Mehdi-Ldj/lora-ble-sensor-node/docs/renders/board-3d-bottom.png

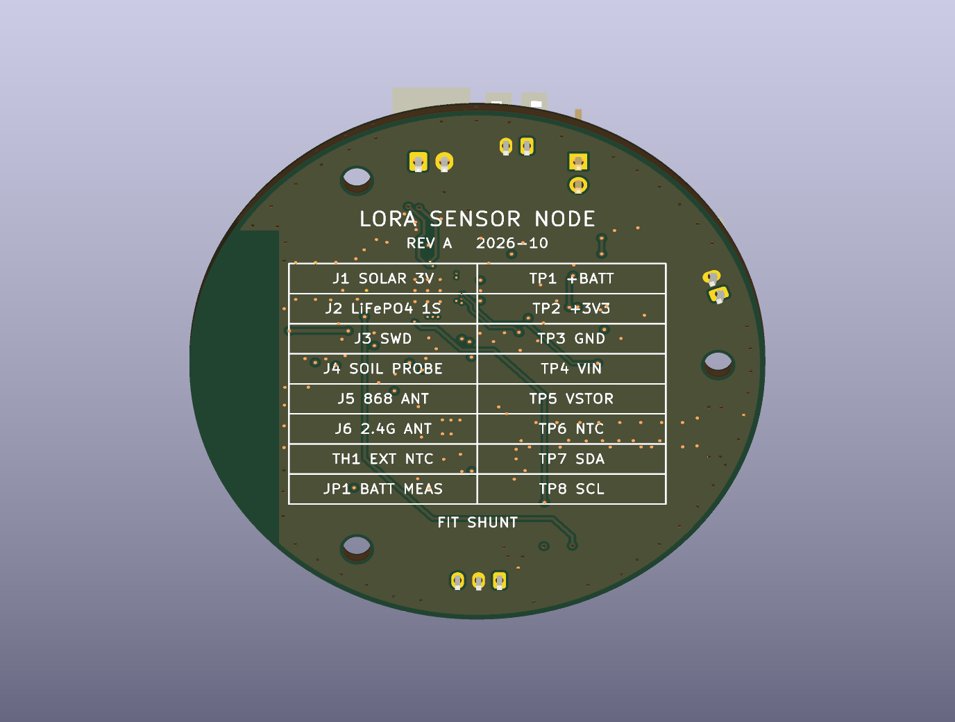
docs/renders/board-3d-bottom.png
