Mehdi-Ldj/lora-ble-sensor-node/hardware/rev-a/3dmodels/SMD1812P050TF-30.step

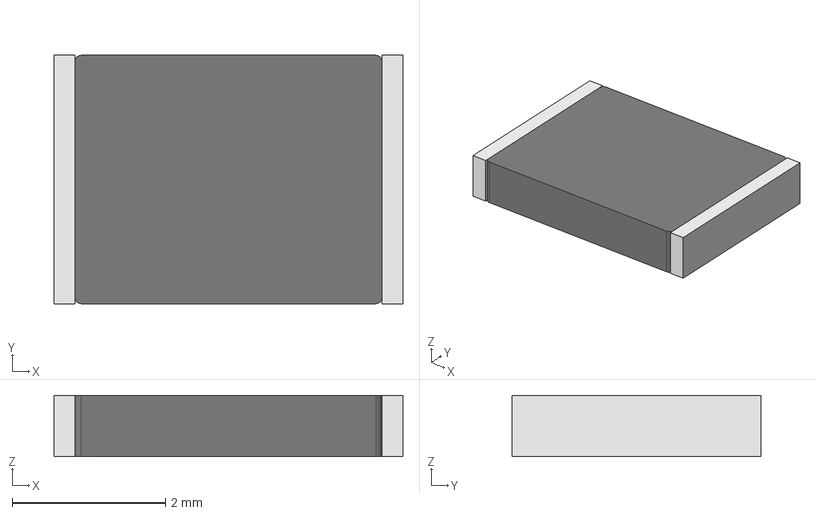
[picture p8: CAD file, 2026-10-28]
hardware/rev-a/3dmodels/SMD1812P050TF-30.step
4.55 x 3.24 x 0.8 mm
cap_-1
cap_1
