Mehdi-Ldj/lora-ble-sensor-node/hardware/rev-a/3dmodels/MM8130-2600.step

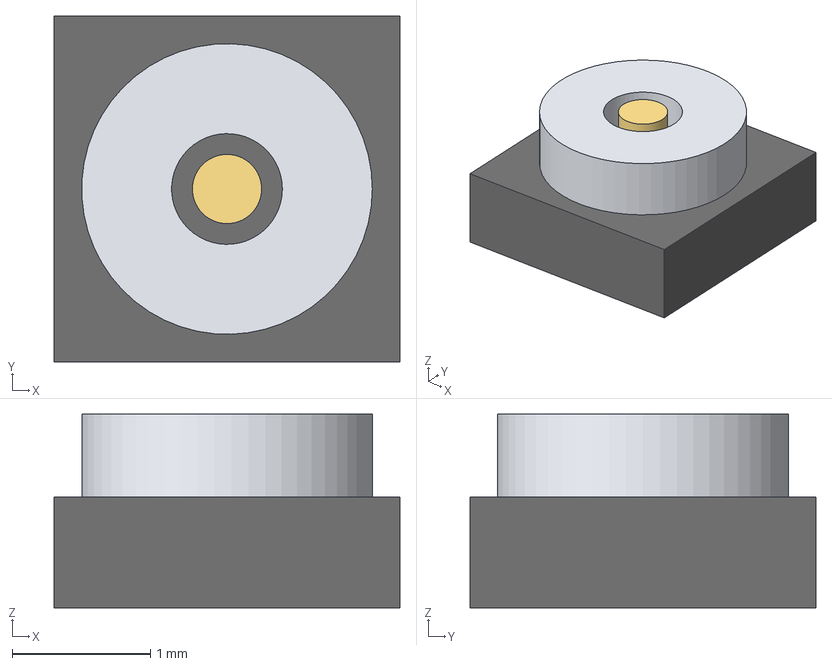
[picture p9: CAD file, 2026-10-28]
hardware/rev-a/3dmodels/MM8130-2600.step
2.50 x 2.50 x 1.40 mm
base
shield
pin
