Mehdi-Ldj/lora-ble-sensor-node/docs/renders/schematic-rev-a.pdf

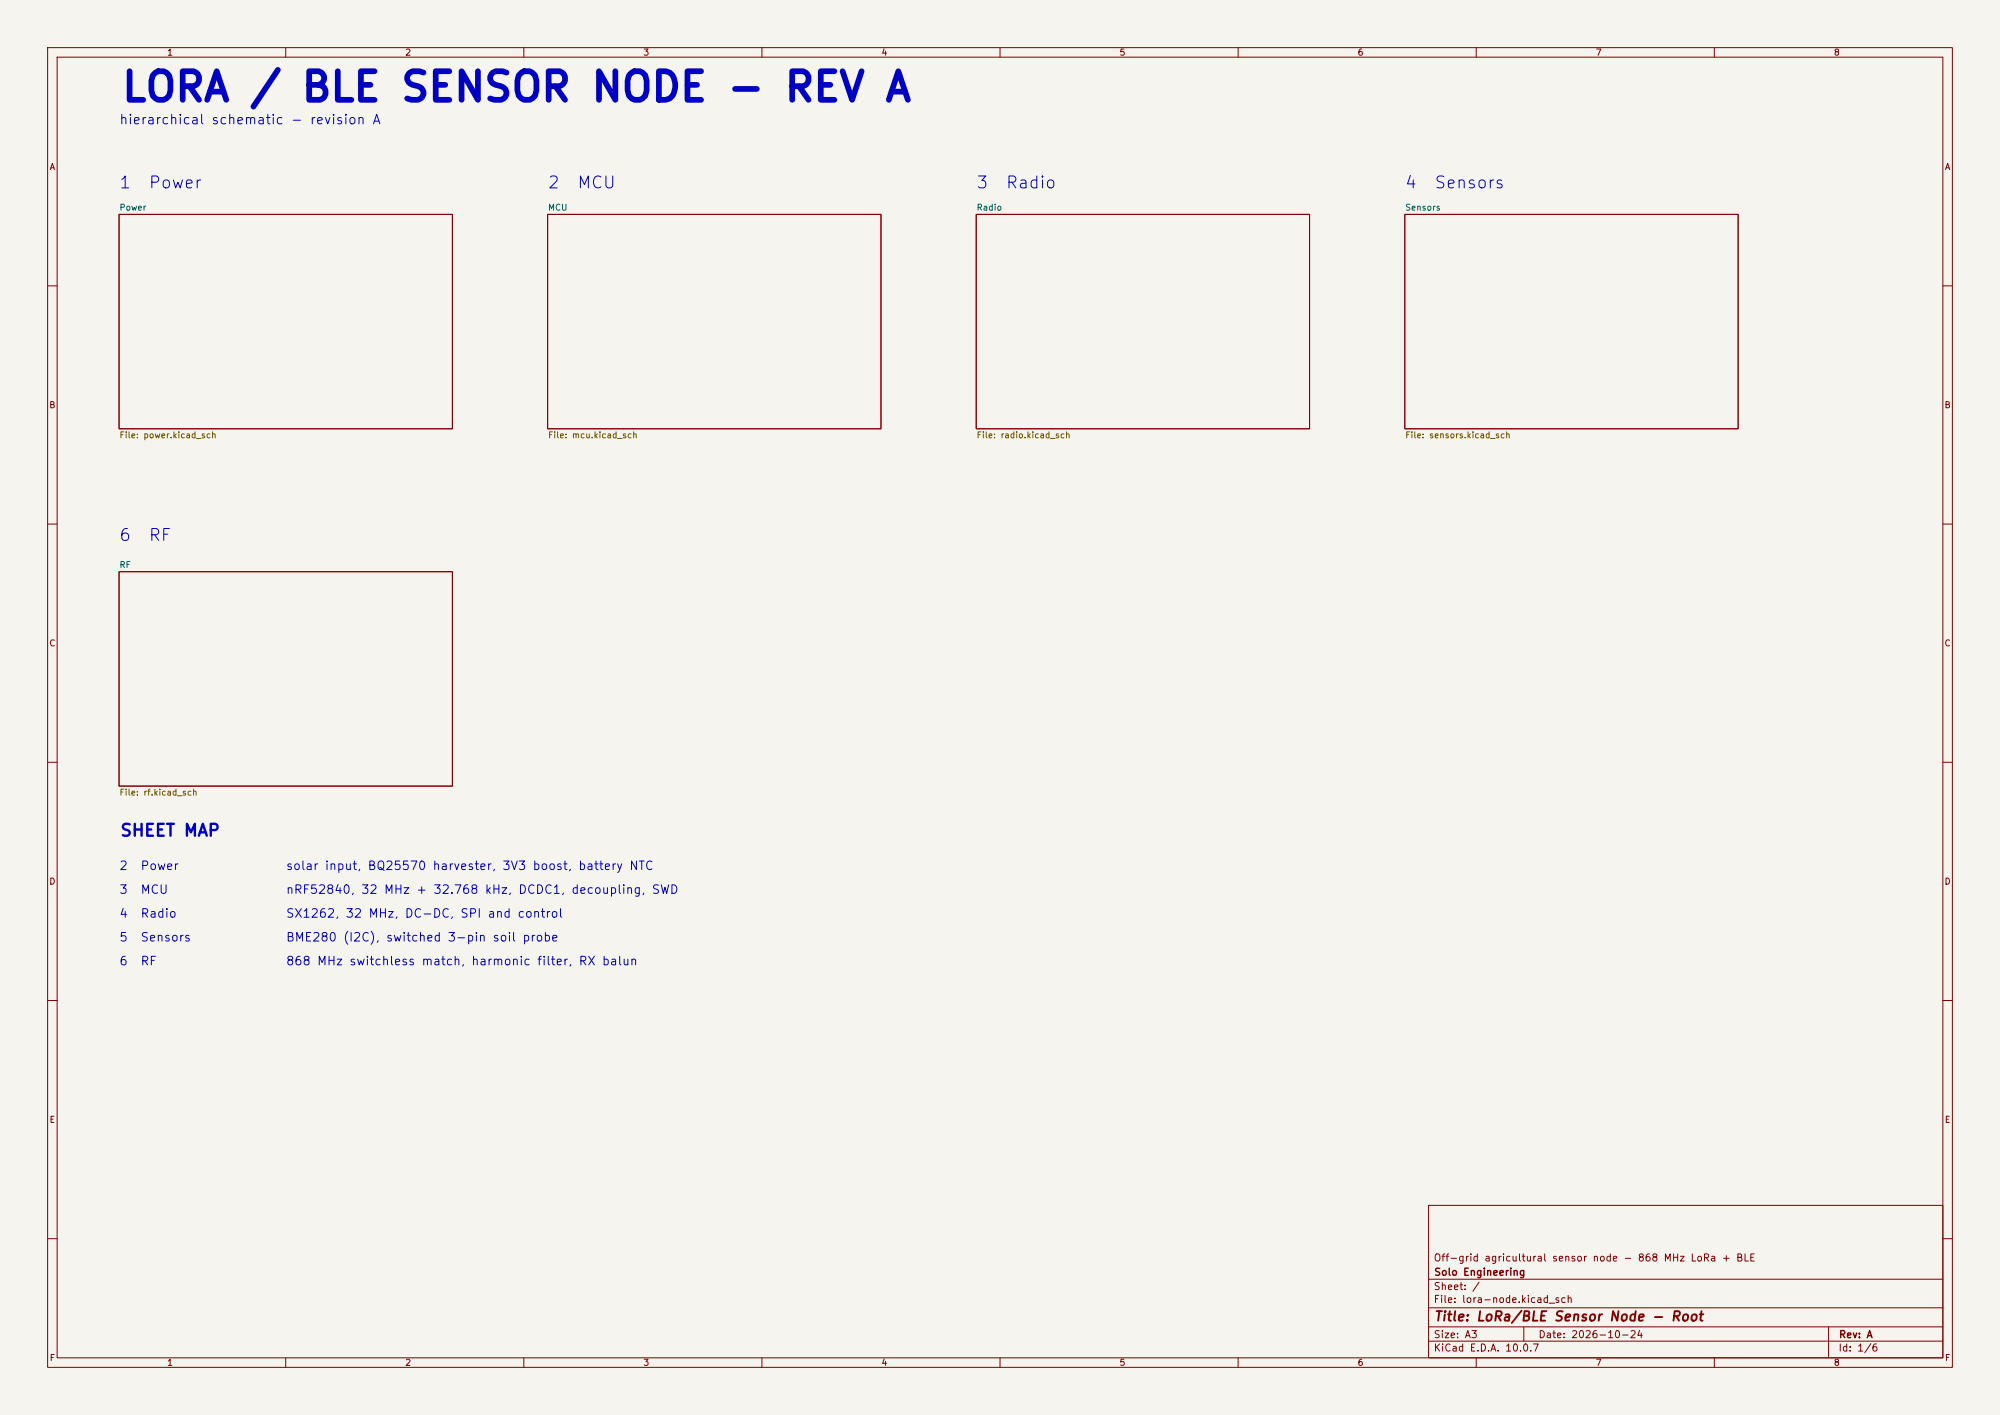
[picture p10: page 1]

LORA / BLE SENSOR NODE - REV A

File: mcu.kicad_sch Power File: power.kicad_sch RF

Sensors File: sensors.kicad_sch Radio

solar input, BQ25570 harvester, 3V3 boost, battery NTC
nRF52840, 32 MHz + 32.768 kHz, DCDC1, decoupling, SWD

SX1262, 32 MHz, DC-DC, SPI and control
BME280 (I2C), switched 3-pin soil probe

868 MHz switchless match, harmonic filter, RX balun

Off-grid agricultural sensor node - 868 MHz LoRa + BLE
Solo Engineering
Sheet: /
File: lora-node.kicad_sch
Title: LoRa/BLE Sensor Node - Root

Size: A3 | Rev: A | F Date: 2026-10-24
KiCad E.D.A. 10.0.7 | Id: 1/6

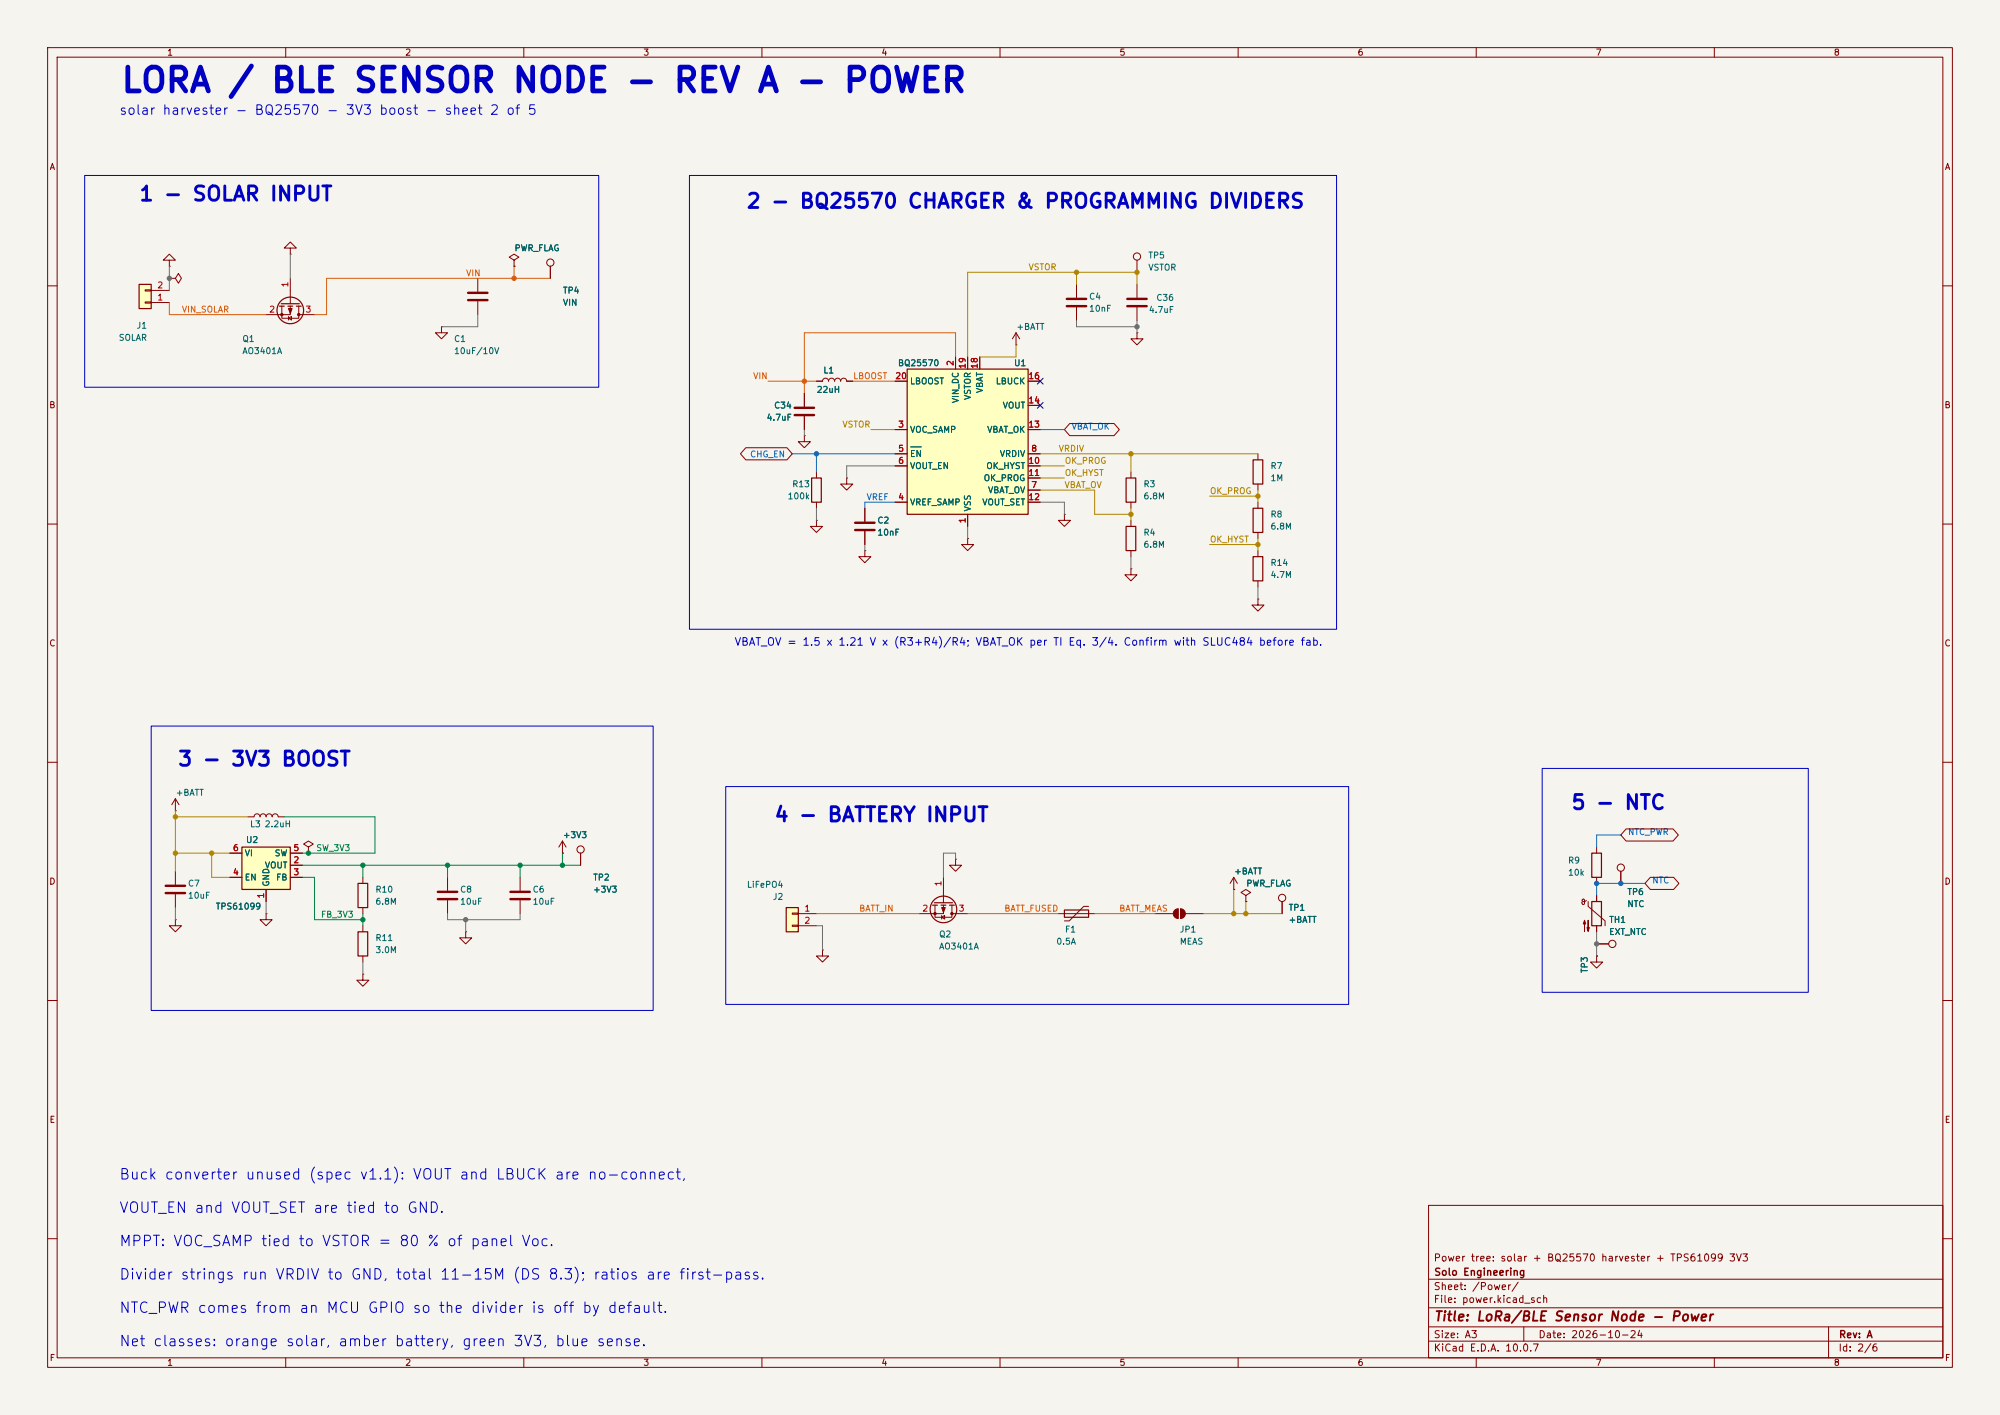
[picture p11: page 2]

LORA / BLE SENSOR NODE - REV A - POWER

solar harvester - BQ25570 - 3V3 boost - sheet 2 of 5

VBAT_OV = 1.5 x 1.21 V x (R3+R4)/R4; VBAT_OK per TI Eq. 3/4. Confirm with SLUC484 before fab.

Power tree: solar + BQ25570 harvester + TPS61099 3V3 +BATT L3 2.2uH GND

Buck converter unused (spec v1.1): VOUT and LBUCK are no-connect,

VOUT_EN and VOUT_SET are tied to GND.

MPPT: VOC_SAMP tied to VSTOR = 80 % of panel Voc.

Divider strings run VRDIV to GND, total 11-15M (DS 8.3); ratios are first-pass.

Solo Engineering
Sheet: /Power/
File: power.kicad_sch
Title: LoRa/BLE Sensor Node - Power

NTC_PWR comes from an MCU GPIO so the divider is off by default.

Net classes: orange solar, amber battery, green 3V3, blue sense.

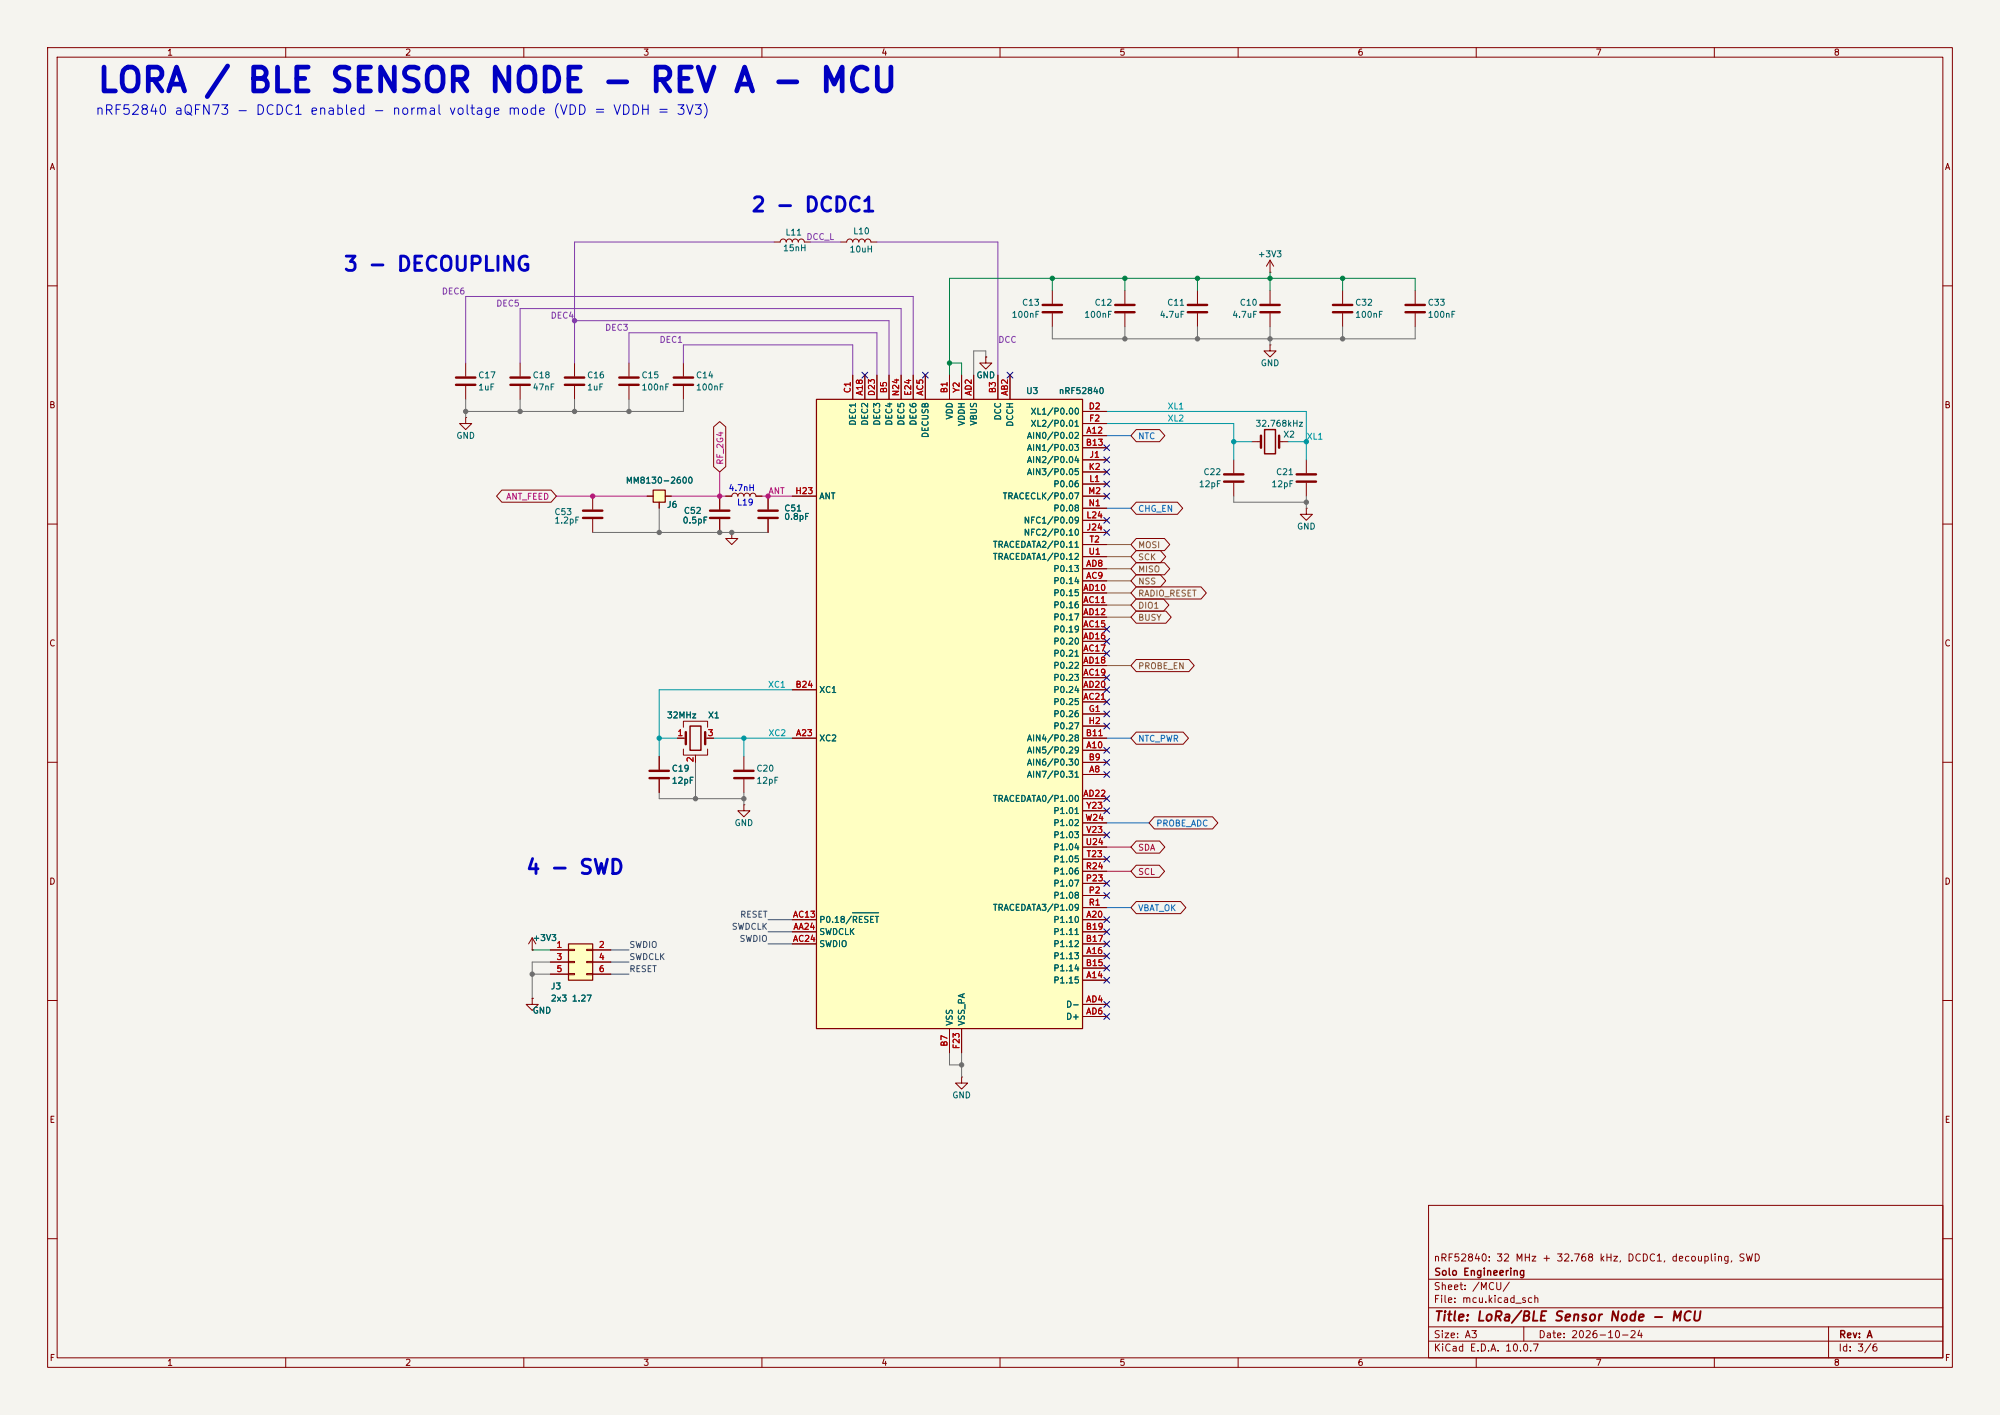
[picture p12: page 3]

4.7nH LORA / BLE SENSOR NODE - REV A - MCU

ANT DEC3 nRF52840 aQFN73 - DCDC1 enabled - normal voltage mode (VDD = VDDH = 3V3)

nRF52840: 32 MHz + 32.768 kHz, DCDC1, decoupling, SWD
Solo Engineering
Sheet: /MCU/
File: mcu.kicad_sch
Title: LoRa/BLE Sensor Node - MCU

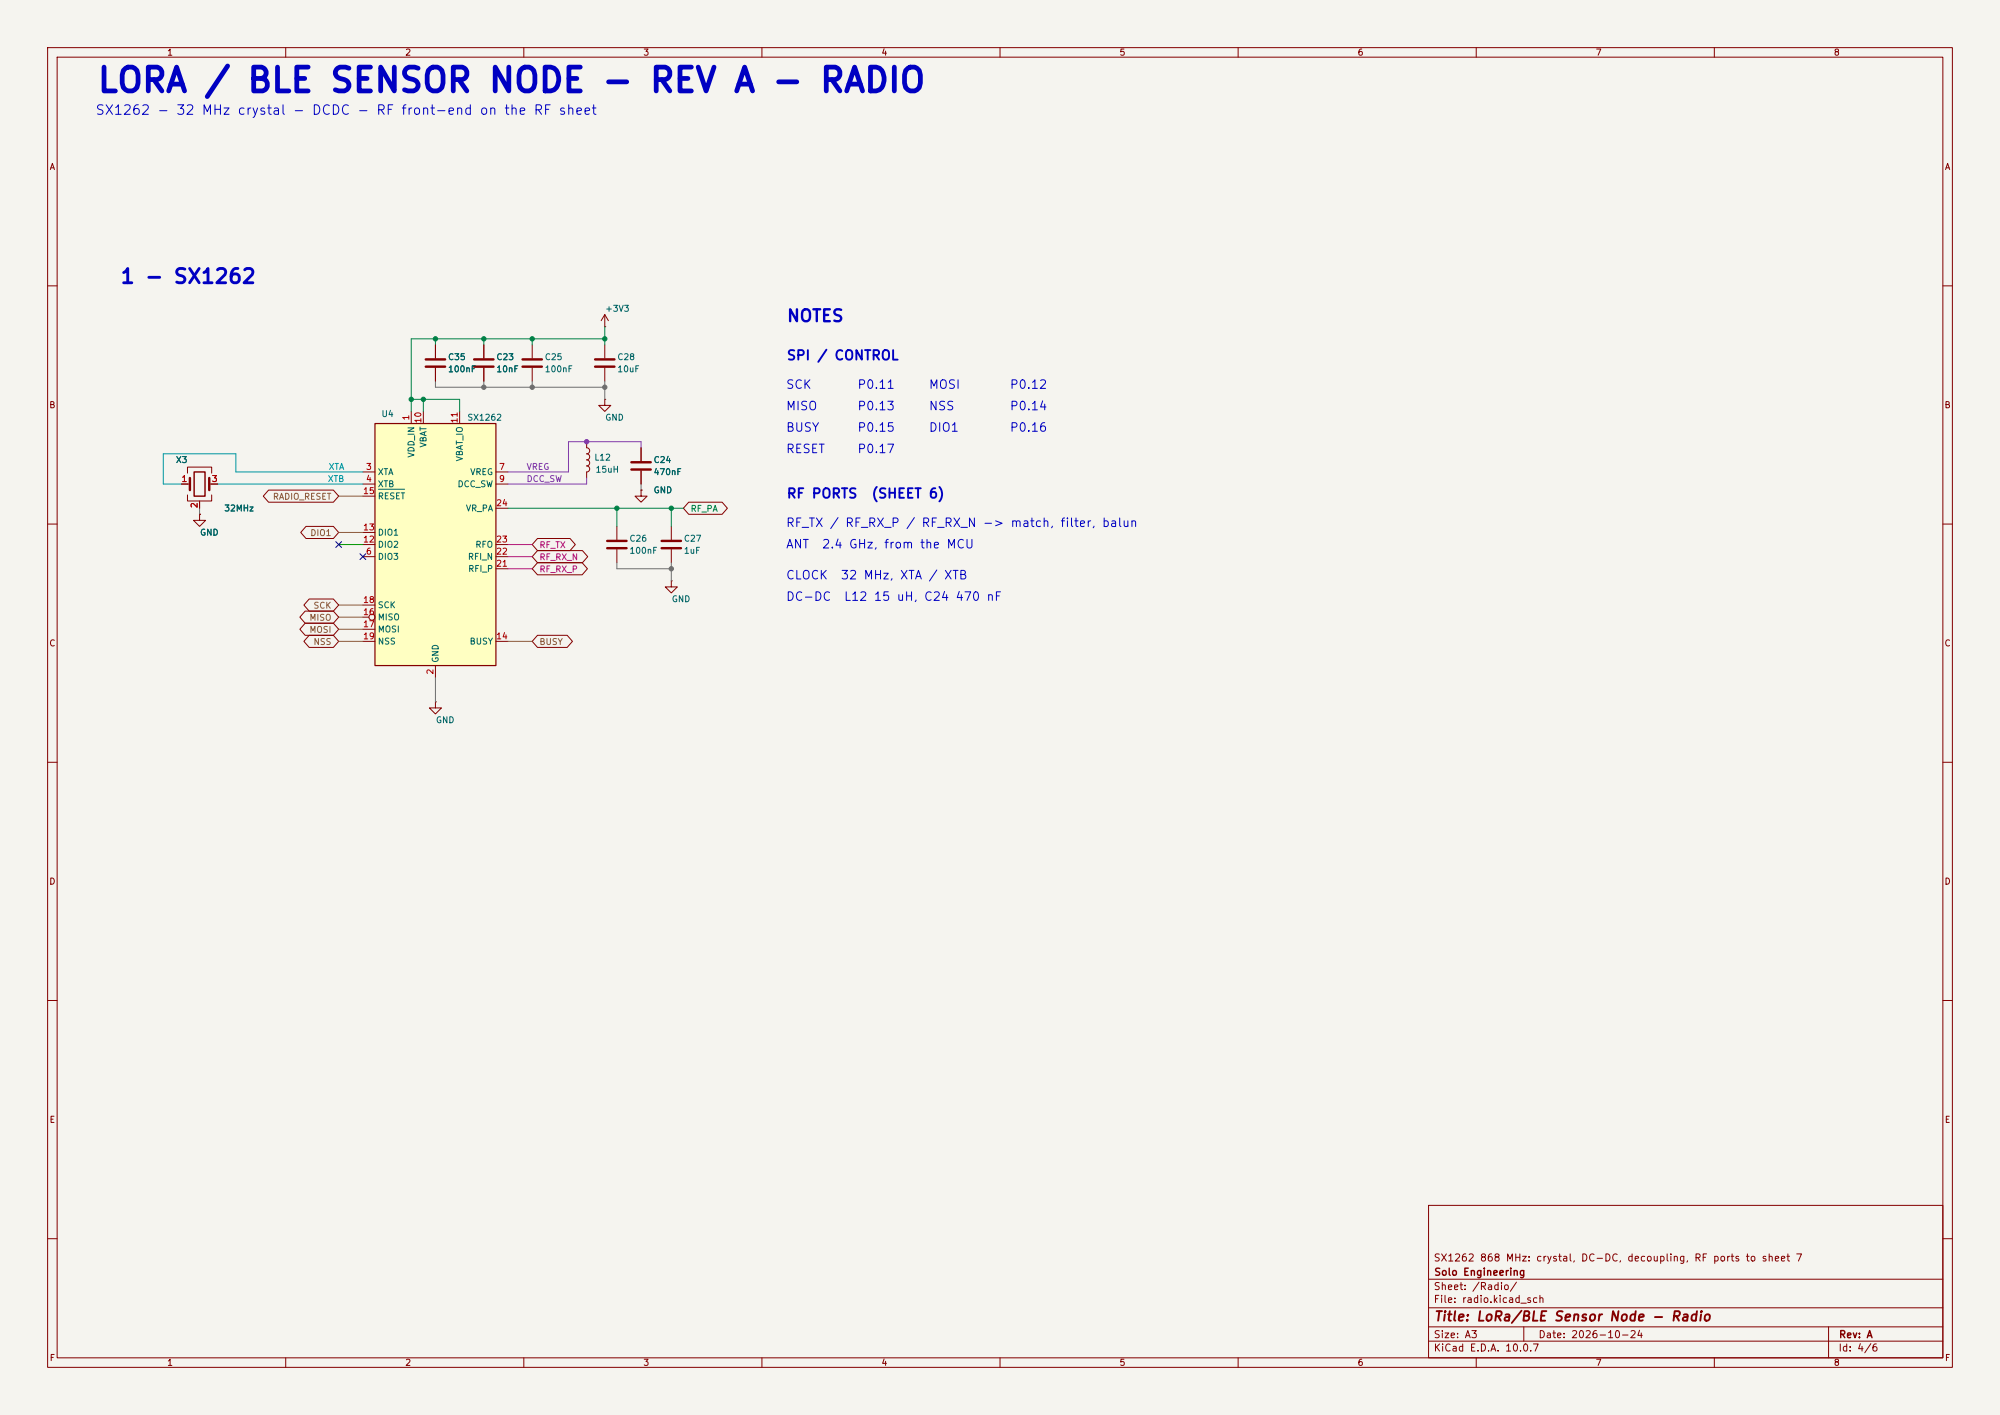
[picture p13: page 4]

LORA / BLE SENSOR NODE - REV A - RADIO

SX1262 - 32 MHz crystal - DCDC - RF front-end on the RF sheet

RF_TX / RF_RX_P / RF_RX_N -> match, filter, balun
ANT 2.4 GHz, from the MCU

CLOCK 32 MHz, XTA / XTB

SX1262 868 MHz: crystal, DC-DC, decoupling, RF ports to sheet 7
Solo Engineering
Sheet: /Radio/
File: radio.kicad_sch
Title: LoRa/BLE Sensor Node - Radio

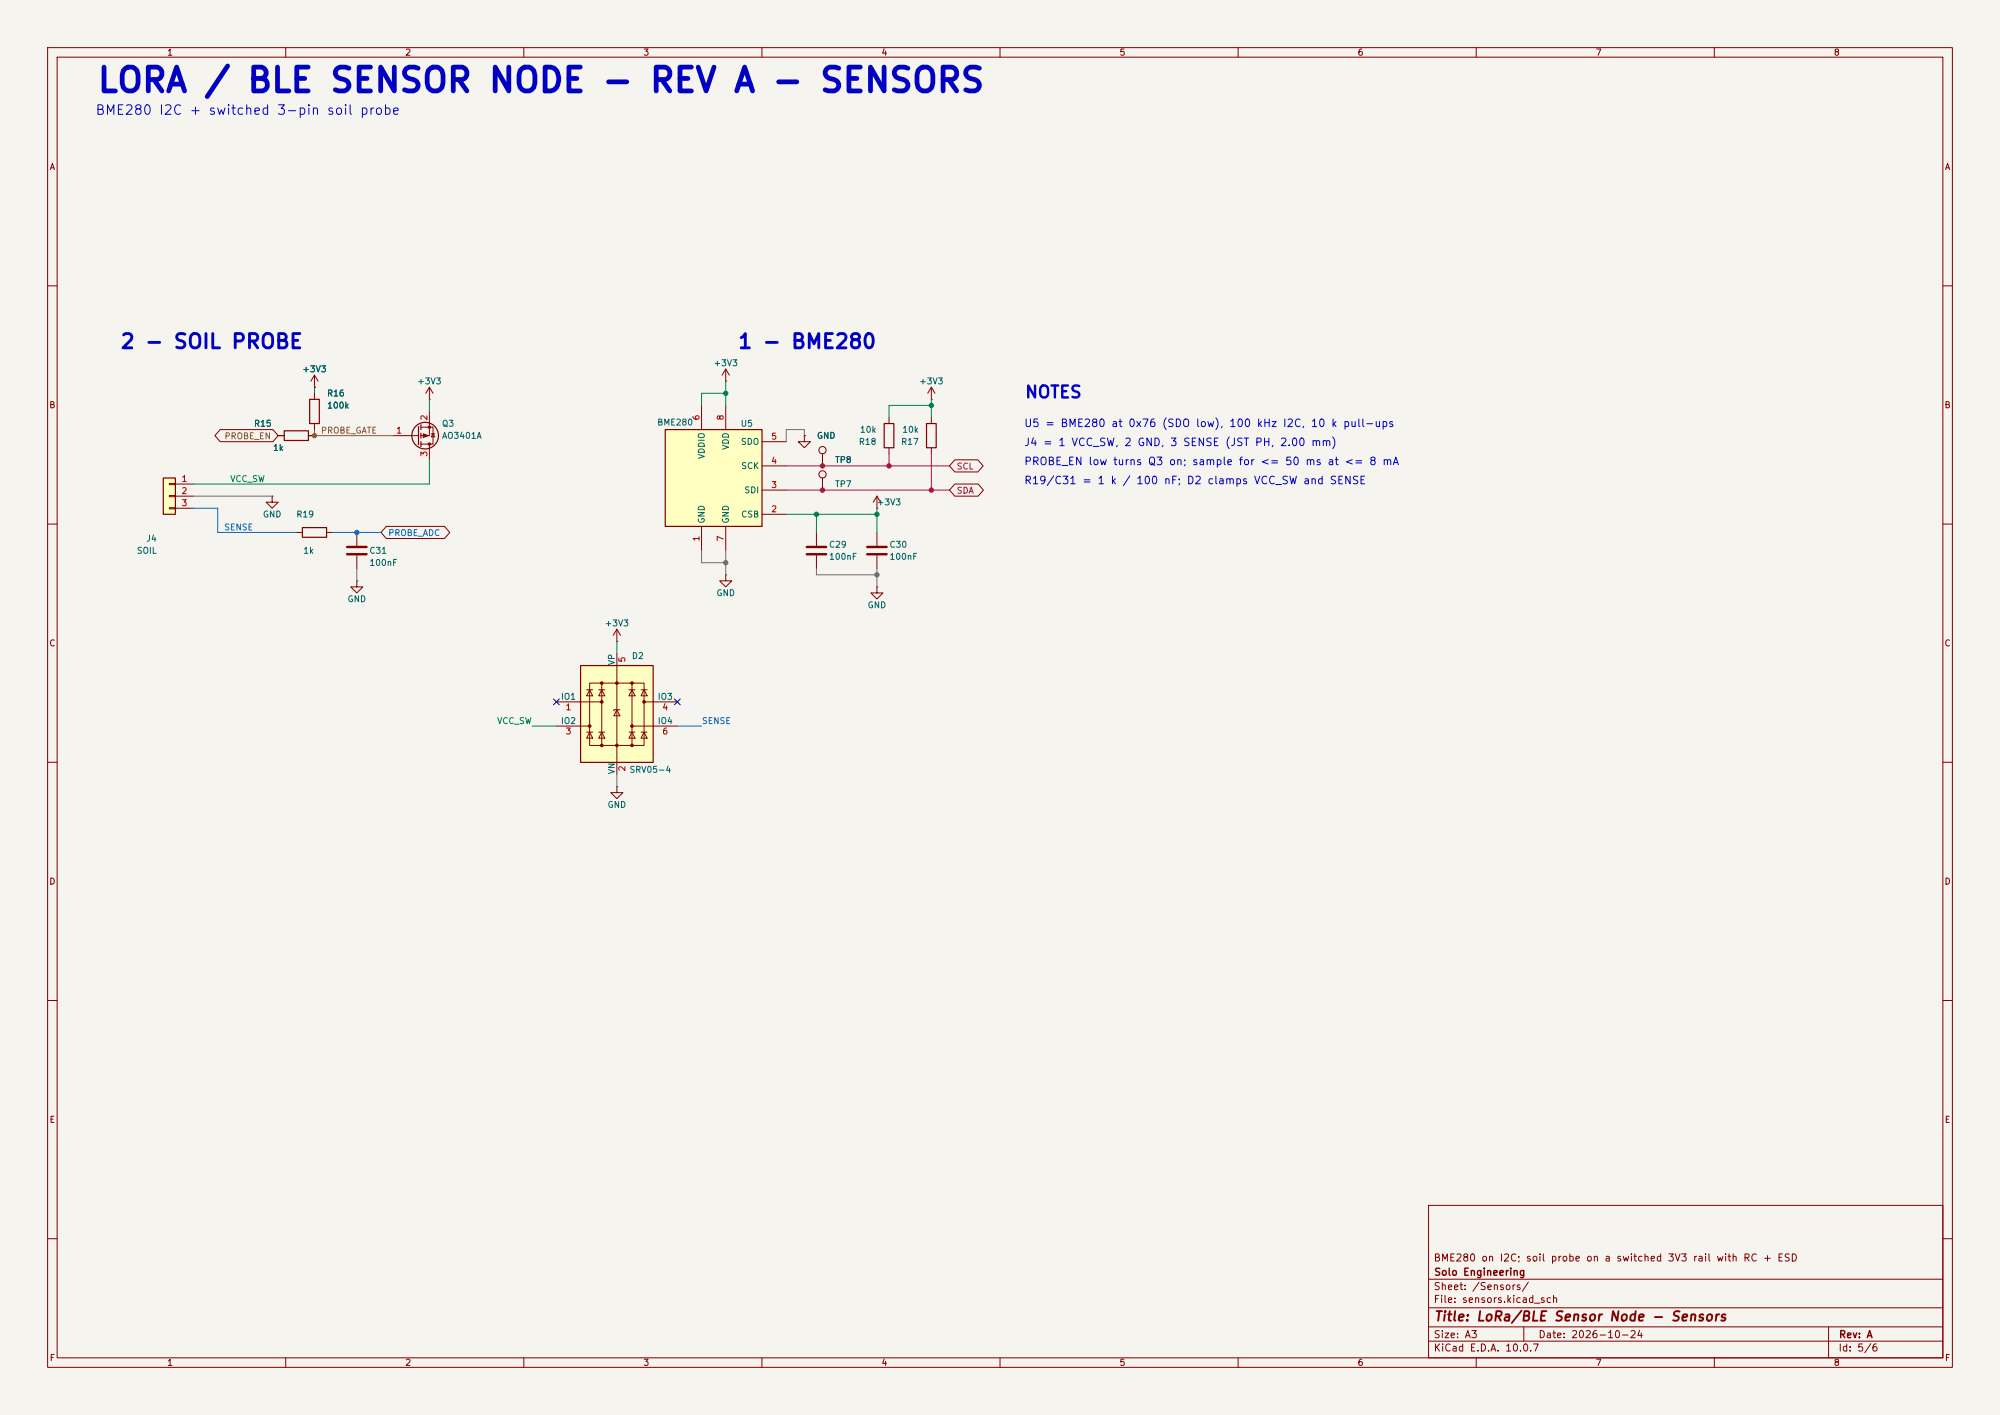
[picture p14: page 5]

LORA / BLE SENSOR NODE - REV A - SENSORS

VCC_SW BME280 I2C + switched 3-pin soil probe

U5 = BME280 at 0x76 (SDO low), 100 kHz I2C, 10 k pull-ups
J4 = 1 VCC_SW, 2 GND, 3 SENSE (JST PH, 2.00 mm)
PROBE_EN low turns Q3 on; sample for <= 50 ms at <= 8 mA
R19/C31 = 1 k / 100 nF; D2 clamps VCC_SW and SENSE

BME280 on I2C; soil probe on a switched 3V3 rail with RC + ESD
Solo Engineering
Sheet: /Sensors/
File: sensors.kicad_sch
Title: LoRa/BLE Sensor Node - Sensors

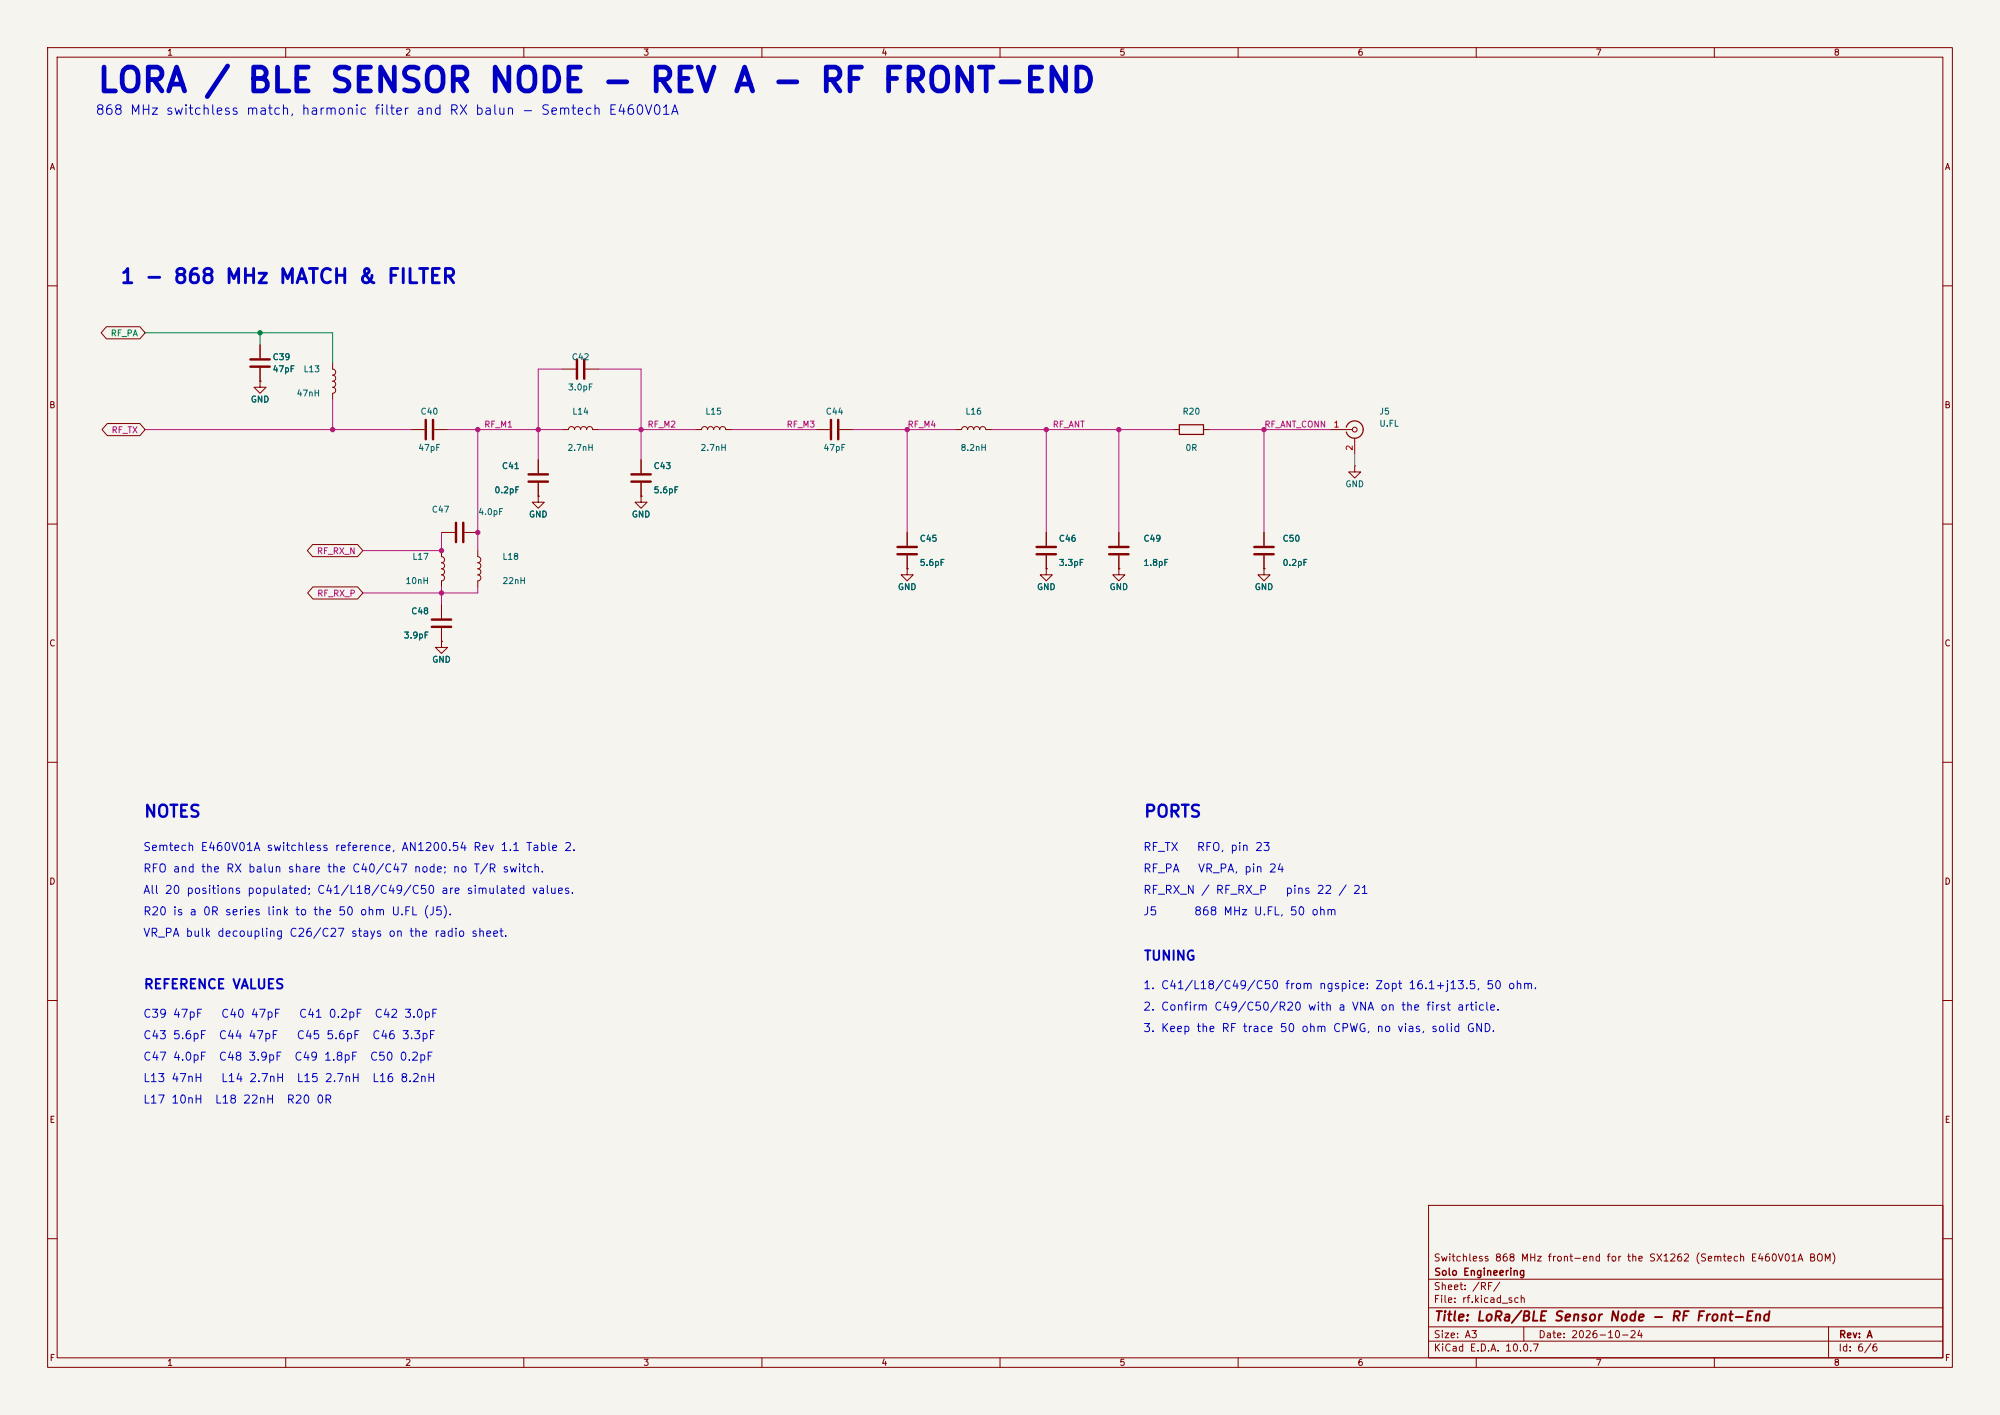
[picture p15: page 6]

LORA / BLE SENSOR NODE - REV A - RF FRONT-END

868 MHz switchless match, harmonic filter and RX balun - Semtech E460V01A

Semtech E460V01A switchless reference, AN1200.54 Rev 1.1 Table 2.
RFO and the RX balun share the C40/C47 node; no T/R switch.
All 20 positions populated; C41/L18/C49/C50 are simulated values.
R20 is a 0R series link to the 50 ohm U.FL (J5).
VR_PA bulk decoupling C26/C27 stays on the radio sheet.

1. C41/L18/C49/C50 from ngspice: Zopt 16.1+j13.5, 50 ohm.
2. Confirm C49/C50/R20 with a VNA on the first article.

Switchless 868 MHz front-end for the SX1262 (Semtech E460V01A BOM)
Solo Engineering
Sheet: /RF/
File: rf.kicad_sch
Title: LoRa/BLE Sensor Node - RF Front-End
