Mehdi-Ldj/lora-ble-sensor-node/hardware/rev-a/lora-node.kicad_pcb

## KiCad design hardware/rev-a/lora-node.kicad_pcb (2026-10-28)

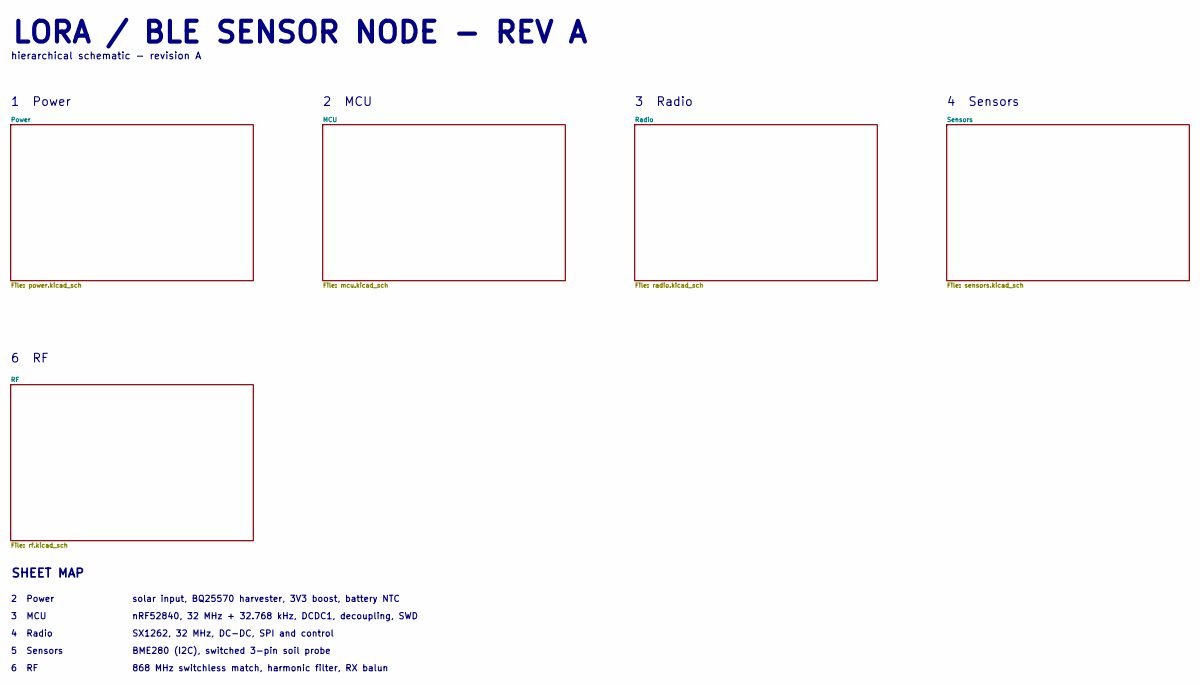
[picture p16: schematic lora-node.kicad_sch, LoRa/BLE Sensor Node - Root]

Notes on the sheet:
5 Sensors
4 Radio
2 MCU
3 MCU
2 Power
6 RF
SHEET MAP
BME280 (I2C), switched 3-pin soil probe
SX1262, 32 MHz, DC-DC, SPI and control
hierarchical schematic - revision A
LORA / BLE SENSOR NODE - REV A
1 Power
solar input, BQ25570 harvester, 3V3 boost, battery NTC
3 Radio
868 MHz switchless match, harmonic filter, RX balun
4 Sensors
nRF52840, 32 MHz + 32.768 kHz, DCDC1, decoupling, SWD

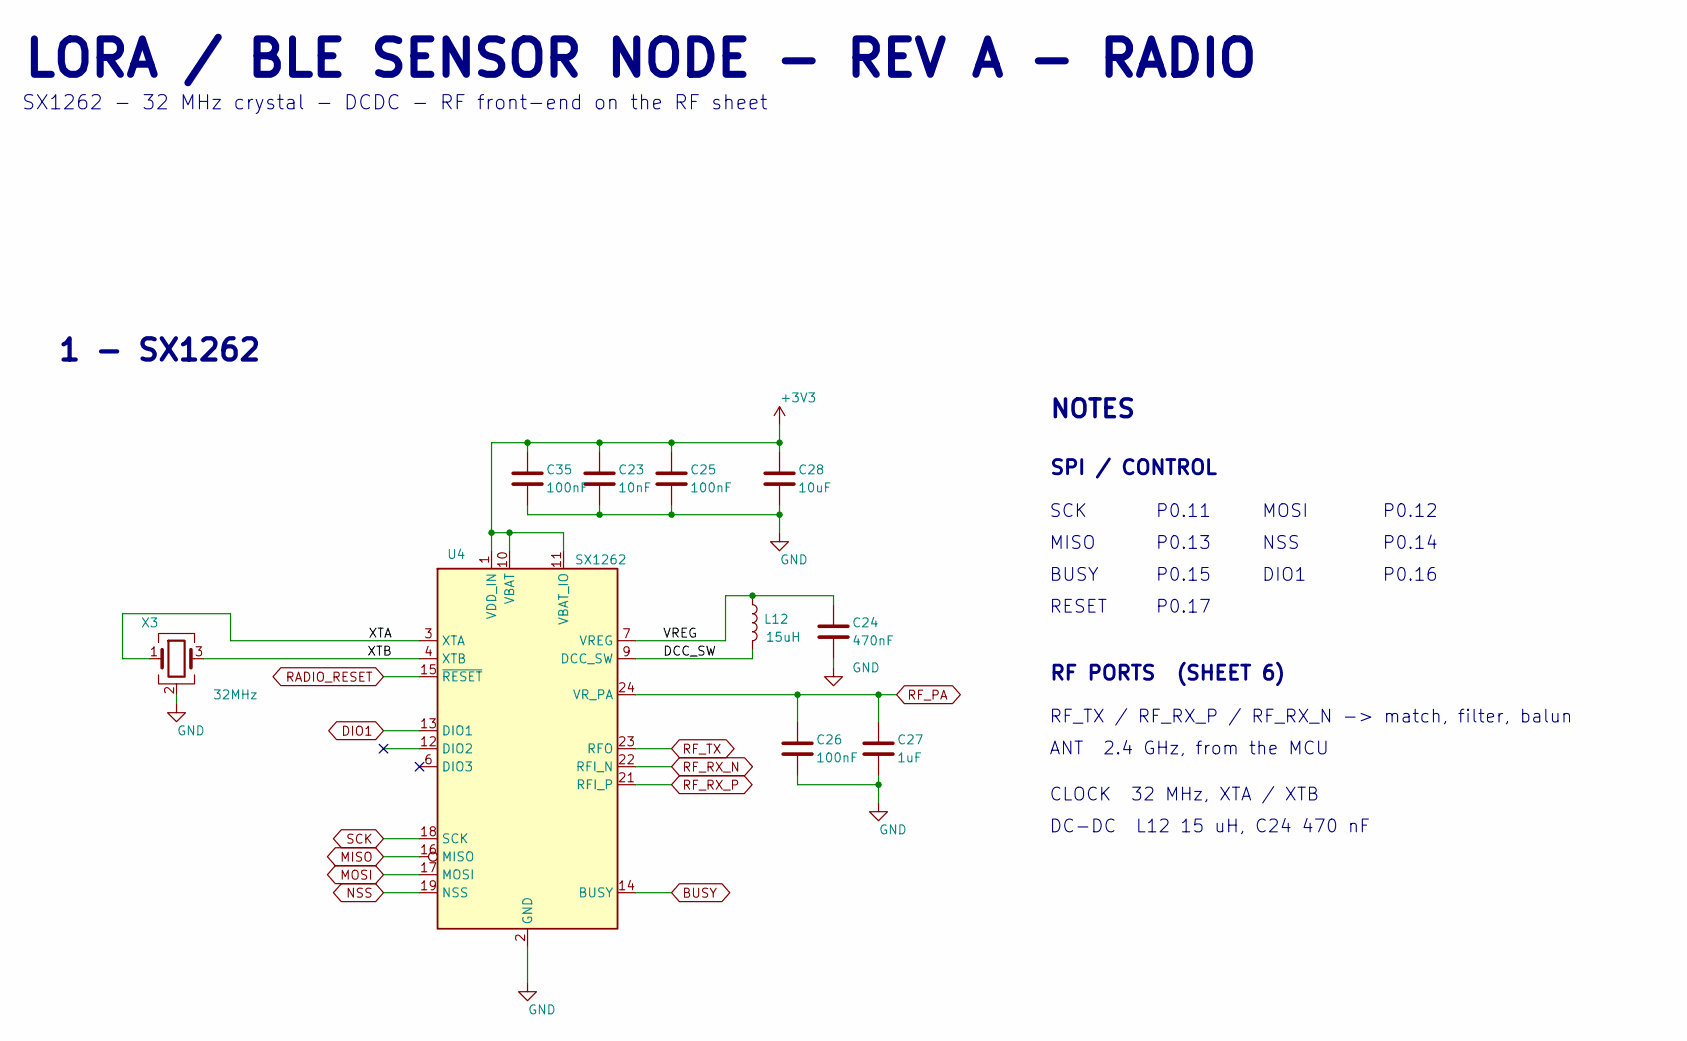
[picture p17: schematic radio.kicad_sch, LoRa/BLE Sensor Node - Radio]

Parts:
C23: 10nF; C_0402_1005Metric; MPN CL05B103KB5NNNC; LCSC C15195
C24: 470nF; C_0402_1005Metric; MPN CL05A474KP5NNNC; LCSC C47339
C25, C26, C35: 100nF; C_0402_1005Metric; MPN CL05B104KO5NNNC; LCSC C1525
C27: 1uF; C_0603_1608Metric; MPN CL10B105KA8NNNC; LCSC C29936
C28: 10uF; C_0805_2012Metric; MPN CL21A106KAYNNNE; LCSC C15850
L12: 15uH; L_0603_1608Metric; MPN MGFL1608F150MT-LF; LCSC C486329
U4: SX1262; QFN-24-1EP_4x4mm_P0.5mm_EP2.6x2.6mm; MPN SX1262IMLTRT; LCSC C191341
X3: 32MHz; Crystal_SMD_2016-4Pin_2.0x1.6mm; MPN ECS-320-10-37B-CKY-TR; LCSC C2450496

Connections:
+3V3: C23.1, C25.1, C28.1, C35.1, U4.1 (VDD_IN), U4.10 (VBAT), U4.11 (VBAT_IO); also elsewhere on the board
/Radio/DCC_SW: L12.2, U4.9 (DCC_SW)
/Radio/VREG: C24.1, L12.1, U4.7 (VREG)
/Radio/XTA: U4.3 (XTA), X3.1
/Radio/XTB: U4.4 (XTB), X3.3
BUSY: U4.14 (BUSY); also elsewhere on the board
DIO1: U4.13 (DIO1); also elsewhere on the board
GND: C23.2, C24.2, C25.2, C26.2, C27.2, C28.2, C35.2, U4.2 (GND), U4.5 (GND), U4.8 (GND), U4.20 (GND), U4.25 (GND), X3.2 (G), X3.4 (G); also elsewhere on the board
MISO: U4.16 (MISO); also elsewhere on the board
MOSI: U4.17 (MOSI); also elsewhere on the board
NSS: U4.19 (NSS); also elsewhere on the board
RADIO_RESET: U4.15 (~RESET); also elsewhere on the board
RF_PA: C26.1, C27.1, U4.24 (VR_PA); also elsewhere on the board
RF_RX_N: U4.22 (RFI_N); also elsewhere on the board
RF_RX_P: U4.21 (RFI_P); also elsewhere on the board
RF_TX: U4.23 (RFO); also elsewhere on the board
SCK: U4.18 (SCK); also elsewhere on the board

Notes on the sheet:
SPI / CONTROL
P0.11
DIO1
RF PORTS (SHEET 6)
1 - SX1262
CLOCK 32 MHz, XTA / XTB
DC-DC L12 15 uH, C24 470 nF
NSS
NOTES
BUSY
MOSI
LORA / BLE SENSOR NODE - REV A - RADIO
P0.16
SCK
SX1262 - 32 MHz crystal - DCDC - RF front-end on the RF sheet
P0.17
RF_TX / RF_RX_P / RF_RX_N -> match, filter, balun
P0.15
RESET
ANT 2.4 GHz, from the MCU
P0.12
P0.13
MISO
P0.14

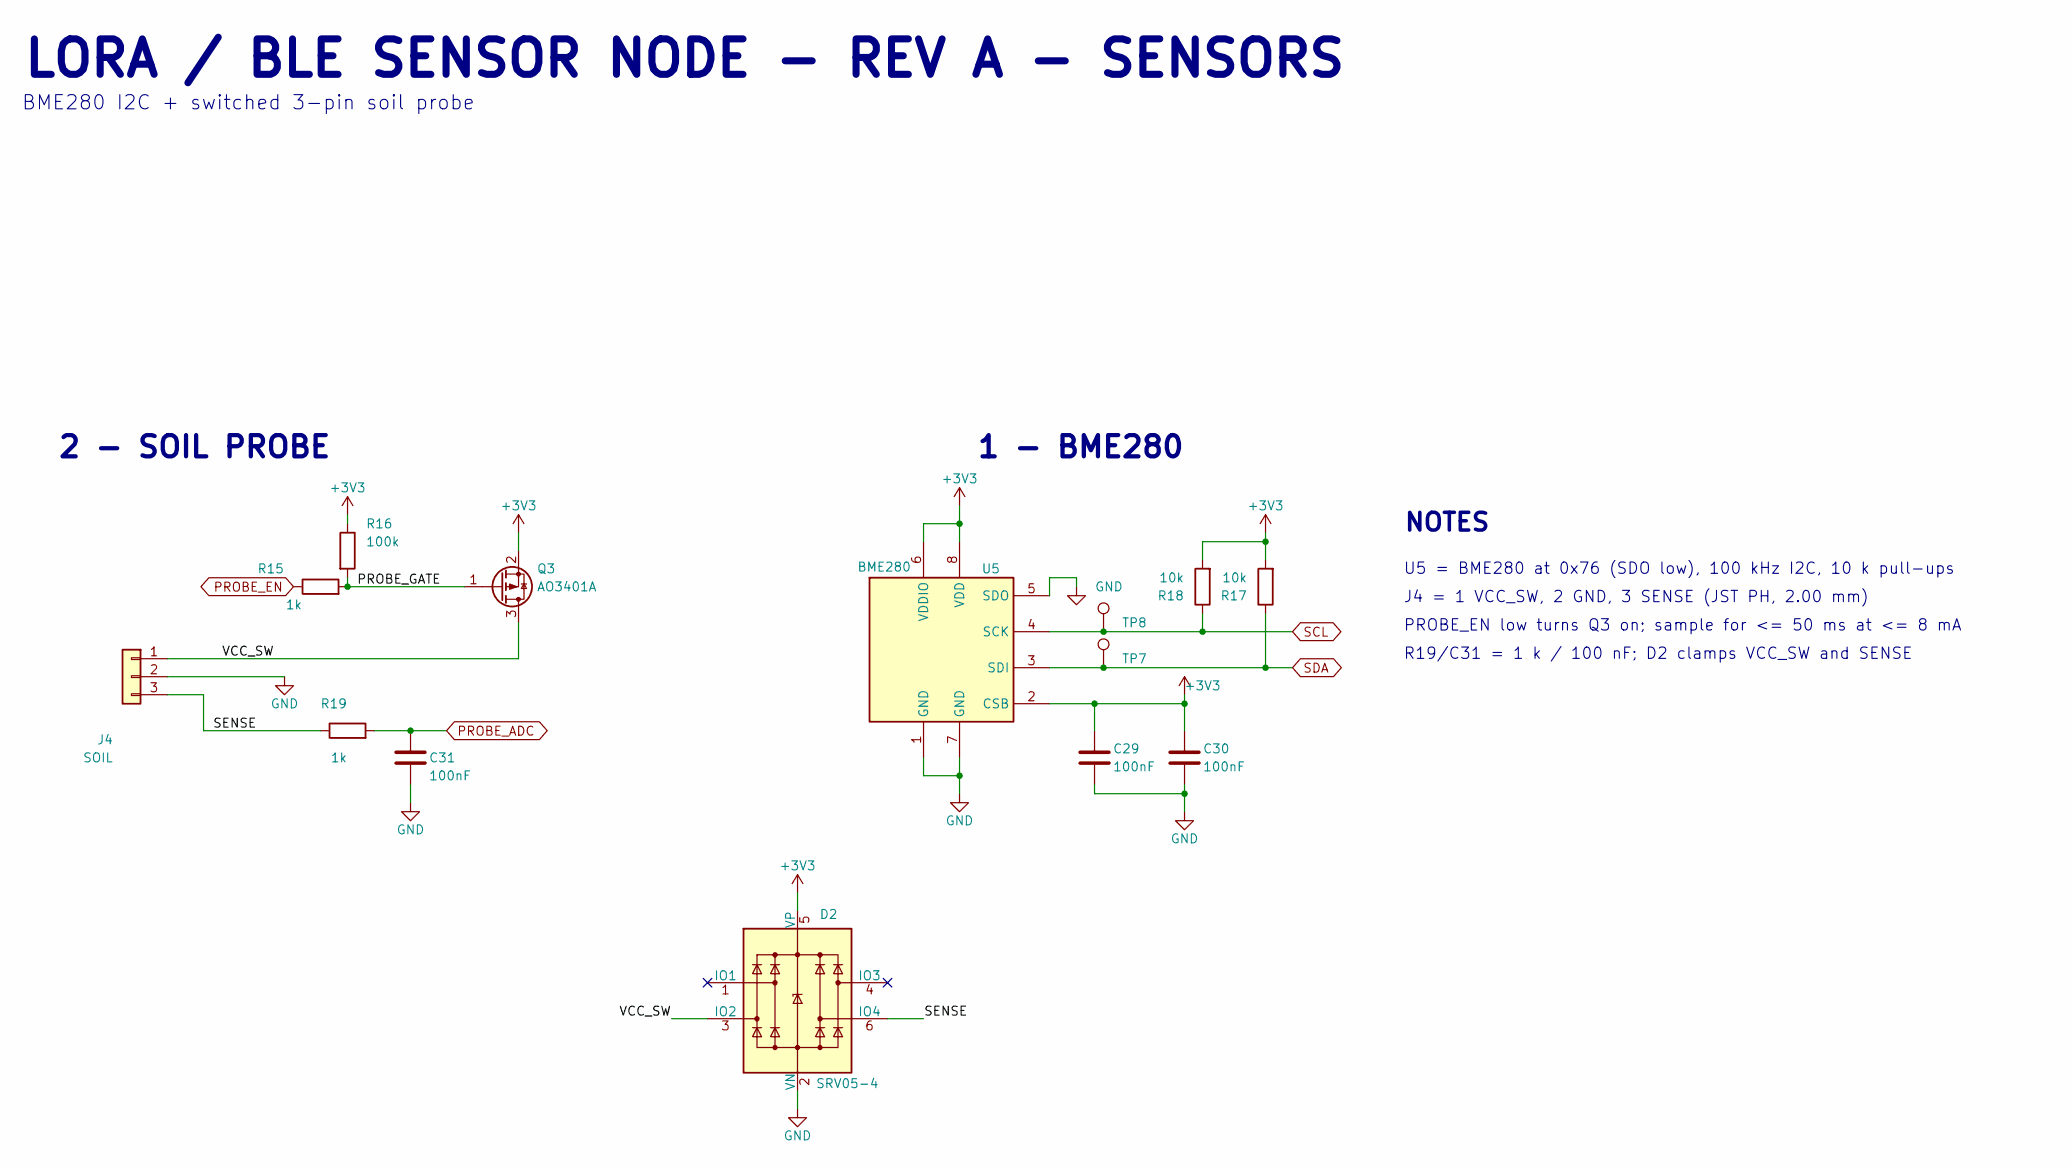
[picture p18: schematic sensors.kicad_sch, LoRa/BLE Sensor Node - Sensors]

Parts:
C29, C30, C31: 100nF; C_0402_1005Metric; MPN CL05B104KO5NNNC; LCSC C1525
D2: SRV05-4; SOT-23-6; MPN SRV05-4.TCT; LCSC C13612
J4: SOIL; JST_PH_B3B-PH-K_1x03_P2.00mm_Vertical; MPN B3B-PH-K-S(LF)(SN); LCSC C131339
Q3: AO3401A; SOT-23; MPN AO3401A; LCSC C15127
R15, R19: 1k; R_0402_1005Metric; MPN 0402WGF1001TCE; LCSC C11702
R16: 100k; R_0402_1005Metric; MPN 0402WGF1003TCE; LCSC C25741
R17, R18: 10k; R_0402_1005Metric; MPN RC0402FR-0710KL; LCSC C60490
TP7: SDA; TestPoint_Pad_D1.0mm
TP8: SCL; TestPoint_Pad_D1.0mm
U5: BME280; Bosch_LGA-8_2.5x2.5mm_P0.65mm_ClockwisePinNumbering; MPN BME280; LCSC C92489

Connections:
+3V3: C29.1, C30.1, D2.5 (VP), Q3.2 (S), R16.1, R17.2, R18.2, U5.2 (CSB), U5.6 (VDDIO), U5.8 (VDD); also elsewhere on the board
/Sensors/PROBE_GATE: Q3.1 (G), R15.2, R16.2
/Sensors/SENSE: D2.6 (IO4), J4.3, R19.1
/Sensors/VCC_SW: D2.3 (IO2), J4.1, Q3.3 (D)
GND: C29.2, C30.2, C31.2, D2.2 (VN), J4.2, U5.1 (GND), U5.5 (SDO), U5.7 (GND); also elsewhere on the board
PROBE_ADC: C31.1, R19.2; also elsewhere on the board
PROBE_EN: R15.1; also elsewhere on the board
SCL: R18.1, TP8.1 (1_1), U5.4 (SCK); also elsewhere on the board
SDA: R17.1, TP7.1 (1_1), U5.3 (SDI); also elsewhere on the board

Notes on the sheet:
J4 = 1 VCC_SW, 2 GND, 3 SENSE (JST PH, 2.00 mm)
LORA / BLE SENSOR NODE - REV A - SENSORS
BME280 I2C + switched 3-pin soil probe
1 - BME280
NOTES
U5 = BME280 at 0x76 (SDO low), 100 kHz I2C, 10 k pull-ups
2 - SOIL PROBE
PROBE_EN low turns Q3 on; sample for <= 50 ms at <= 8 mA
R19/C31 = 1 k / 100 nF; D2 clamps VCC_SW and SENSE

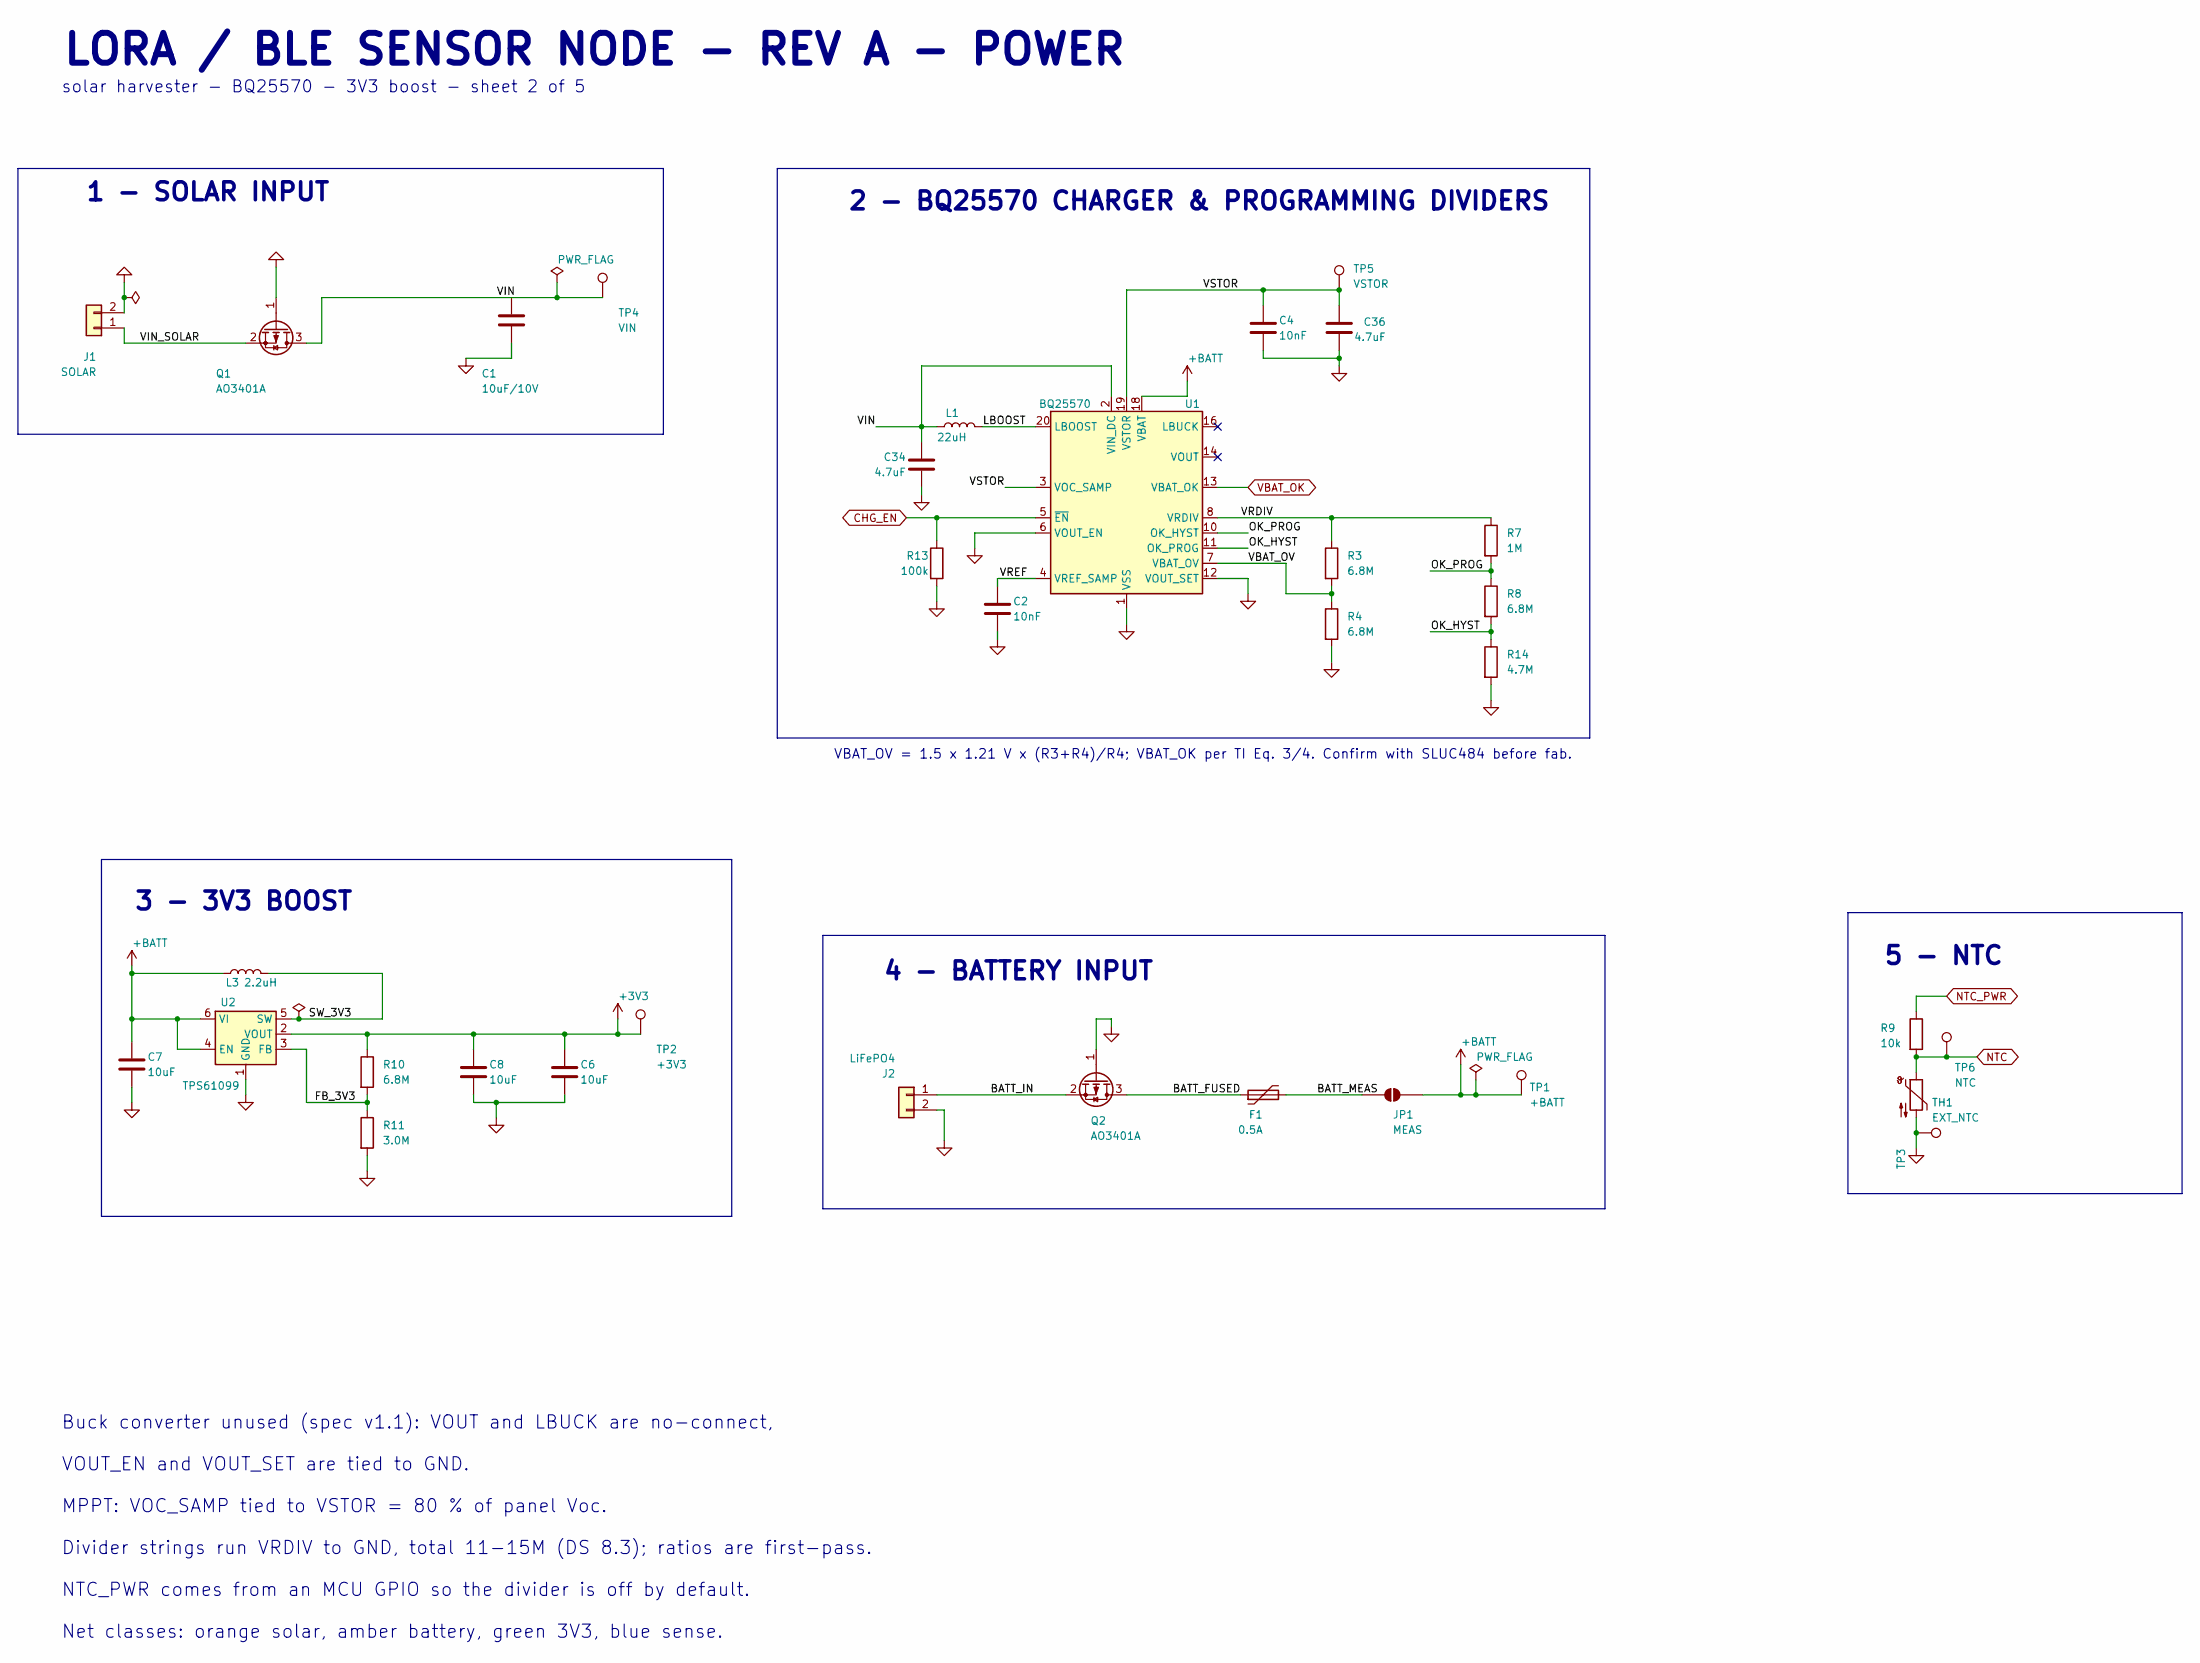
[picture p19: schematic power.kicad_sch, LoRa/BLE Sensor Node - Power]

Parts:
C1: 10uF/10V; C_0805_2012Metric; MPN CL21A106KAYNNNE; LCSC C15850
C2, C4: 10nF; C_0402_1005Metric; MPN CL05B103KB5NNNC; LCSC C15195
C6, C7, C8: 10uF; C_0805_2012Metric; MPN CL21A106KAYNNNE; LCSC C15850
C34, C36: 4.7uF; C_0603_1608Metric; MPN CL10A475KO8NNNC; LCSC C19666
F1: 0.5A; Fuse_1812_4532Metric; MPN SMD1812P050TF/30; LCSC C12559
J1: SOLAR; JST_PH_B2B-PH-K_1x02_P2.00mm_Vertical; MPN B2B-PH-K-S(LF)(SN); LCSC C131337
J2: LiFePO4; JST_PH_B2B-PH-K_1x02_P2.00mm_Vertical; MPN B2B-PH-K-S(LF)(SN); LCSC C131337
JP1: MEAS; PinHeader_1x02_P2.54mm_Vertical; MPN PZ254V-11-02P; LCSC C492401
L1: 22uH; L_1210_3225Metric; MPN CBC3225T220KR; LCSC C223225
L3: 2.2uH; L_1210_3225Metric; MPN DFE322512F-2R2M=P2; LCSC C3222669
Q1, Q2: AO3401A; SOT-23; MPN AO3401A; LCSC C15127
R3, R4, R8, R10: 6.8M; R_0402_1005Metric; MPN RC0402FR-076M8L; LCSC C477777
R7: 1M; R_0402_1005Metric; MPN 0402WGF1004TCE; LCSC C26083
R9: 10k; R_0402_1005Metric; MPN RC0402FR-0710KL; LCSC C60490
R11: 3.0M; R_0402_1005Metric; MPN 0402WGF3004TCE; LCSC C56582
R13: 100k; R_0402_1005Metric; MPN 0402WGF1003TCE; LCSC C25741
R14: 4.7M; R_0402_1005Metric; MPN 0402WGF4704TCE; LCSC C474132
TH1: EXT_NTC; JST_XH_B2B-XH-A_1x02_P2.50mm_Vertical; MPN B2B-XH-A(LF)(SN); LCSC C158012
TP1: +BATT; TestPoint_Pad_D1.0mm
TP2: +3V3; TestPoint_Pad_D1.0mm
TP3: TestPoint_Pad_D1.0mm
TP4: VIN; TestPoint_Pad_D1.0mm
TP5: VSTOR; TestPoint_Pad_D1.0mm
TP6: NTC; TestPoint_Pad_D1.0mm
U1: BQ25570; QFN-20-1EP_3.5x3.5mm_P0.5mm_EP2x2mm; MPN BQ25570RGRR; LCSC C506250
U2: TPS61099; WSON-6-1EP_2x2mm_P0.65mm_EP1x1.6mm; MPN TPS61099DRVR; LCSC C2842395

Connections:
+3V3: C6.1, C8.1, R10.1, TP2.1 (1_1), U2.2 (VOUT); also elsewhere on the board
+BATT: C7.1, JP1.2 (B), L3.1, TP1.1 (1_1), U1.18 (VBAT), U2.4 (EN), U2.6 (VI)
/Power/BATT_FUSED: F1.1, Q2.3 (D)
/Power/BATT_IN: J2.1, Q2.2 (S)
/Power/BATT_MEAS: F1.2, JP1.1 (A)
/Power/FB_3V3: R10.2, R11.1, U2.3 (FB)
/Power/LBOOST: L1.2, U1.20 (LBOOST)
/Power/OK_HYST: R8.2, R14.1, U1.11 (OK_PROG)
/Power/OK_PROG: R7.2, R8.1, U1.10 (OK_HYST)
/Power/SW_3V3: L3.2, U2.5 (SW)
/Power/VBAT_OV: R3.2, R4.1, U1.7 (VBAT_OV)
/Power/VIN: C1.1, C34.1, L1.1, Q1.3 (D), TP4.1 (1_1), U1.2 (VIN_DC)
/Power/VIN_SOLAR: J1.1, Q1.2 (S)
/Power/VRDIV: R3.1, R7.1, U1.8 (VRDIV)
/Power/VREF: C2.1, U1.4 (VREF_SAMP)
/Power/VSTOR: C4.1, C36.1, TP5.1 (1_1), U1.3 (VOC_SAMP), U1.19 (VSTOR)
CHG_EN: R13.1, U1.5 (~EN); also elsewhere on the board
GND: C1.2, C2.2, C4.2, C6.2, C7.2, C8.2, C34.2, C36.2, J1.2, J2.2, Q1.1 (G), Q2.1 (G), R4.2, R11.2, R13.2, R14.2, TH1.2, TP3.1 (1_1), U1.1 (VSS), U1.6 (VOUT_EN), U1.9 (VSS), U1.12 (VOUT_SET), U1.15 (VSS), U1.17 (VSS), U1.21 (VSS), U2.1 (GND), U2.7 (GND); also elsewhere on the board
NTC: R9.2, TH1.1, TP6.1 (1_1); also elsewhere on the board
NTC_PWR: R9.1; also elsewhere on the board
VBAT_OK: U1.13 (VBAT_OK); also elsewhere on the board

Notes on the sheet:
4 - BATTERY INPUT
Net classes: orange solar, amber battery, green 3V3, blue sense.
5 - NTC
Divider strings run VRDIV to GND, total 11-15M (DS 8.3); ratios are first-pass.
solar harvester - BQ25570 - 3V3 boost - sheet 2 of 5
VOUT_EN and VOUT_SET are tied to GND.
MPPT: VOC_SAMP tied to VSTOR = 80 % of panel Voc.
Buck converter unused (spec v1.1): VOUT and LBUCK are no-connect,
1 - SOLAR INPUT
3 - 3V3 BOOST
VBAT_OV = 1.5 x 1.21 V x (R3+R4)/R4; VBAT_OK per TI Eq. 3/4. Confirm with SLUC484 before fab.
LORA / BLE SENSOR NODE - REV A - POWER
NTC_PWR comes from an MCU GPIO so the divider is off by default.
2 - BQ25570 CHARGER & PROGRAMMING DIVIDERS

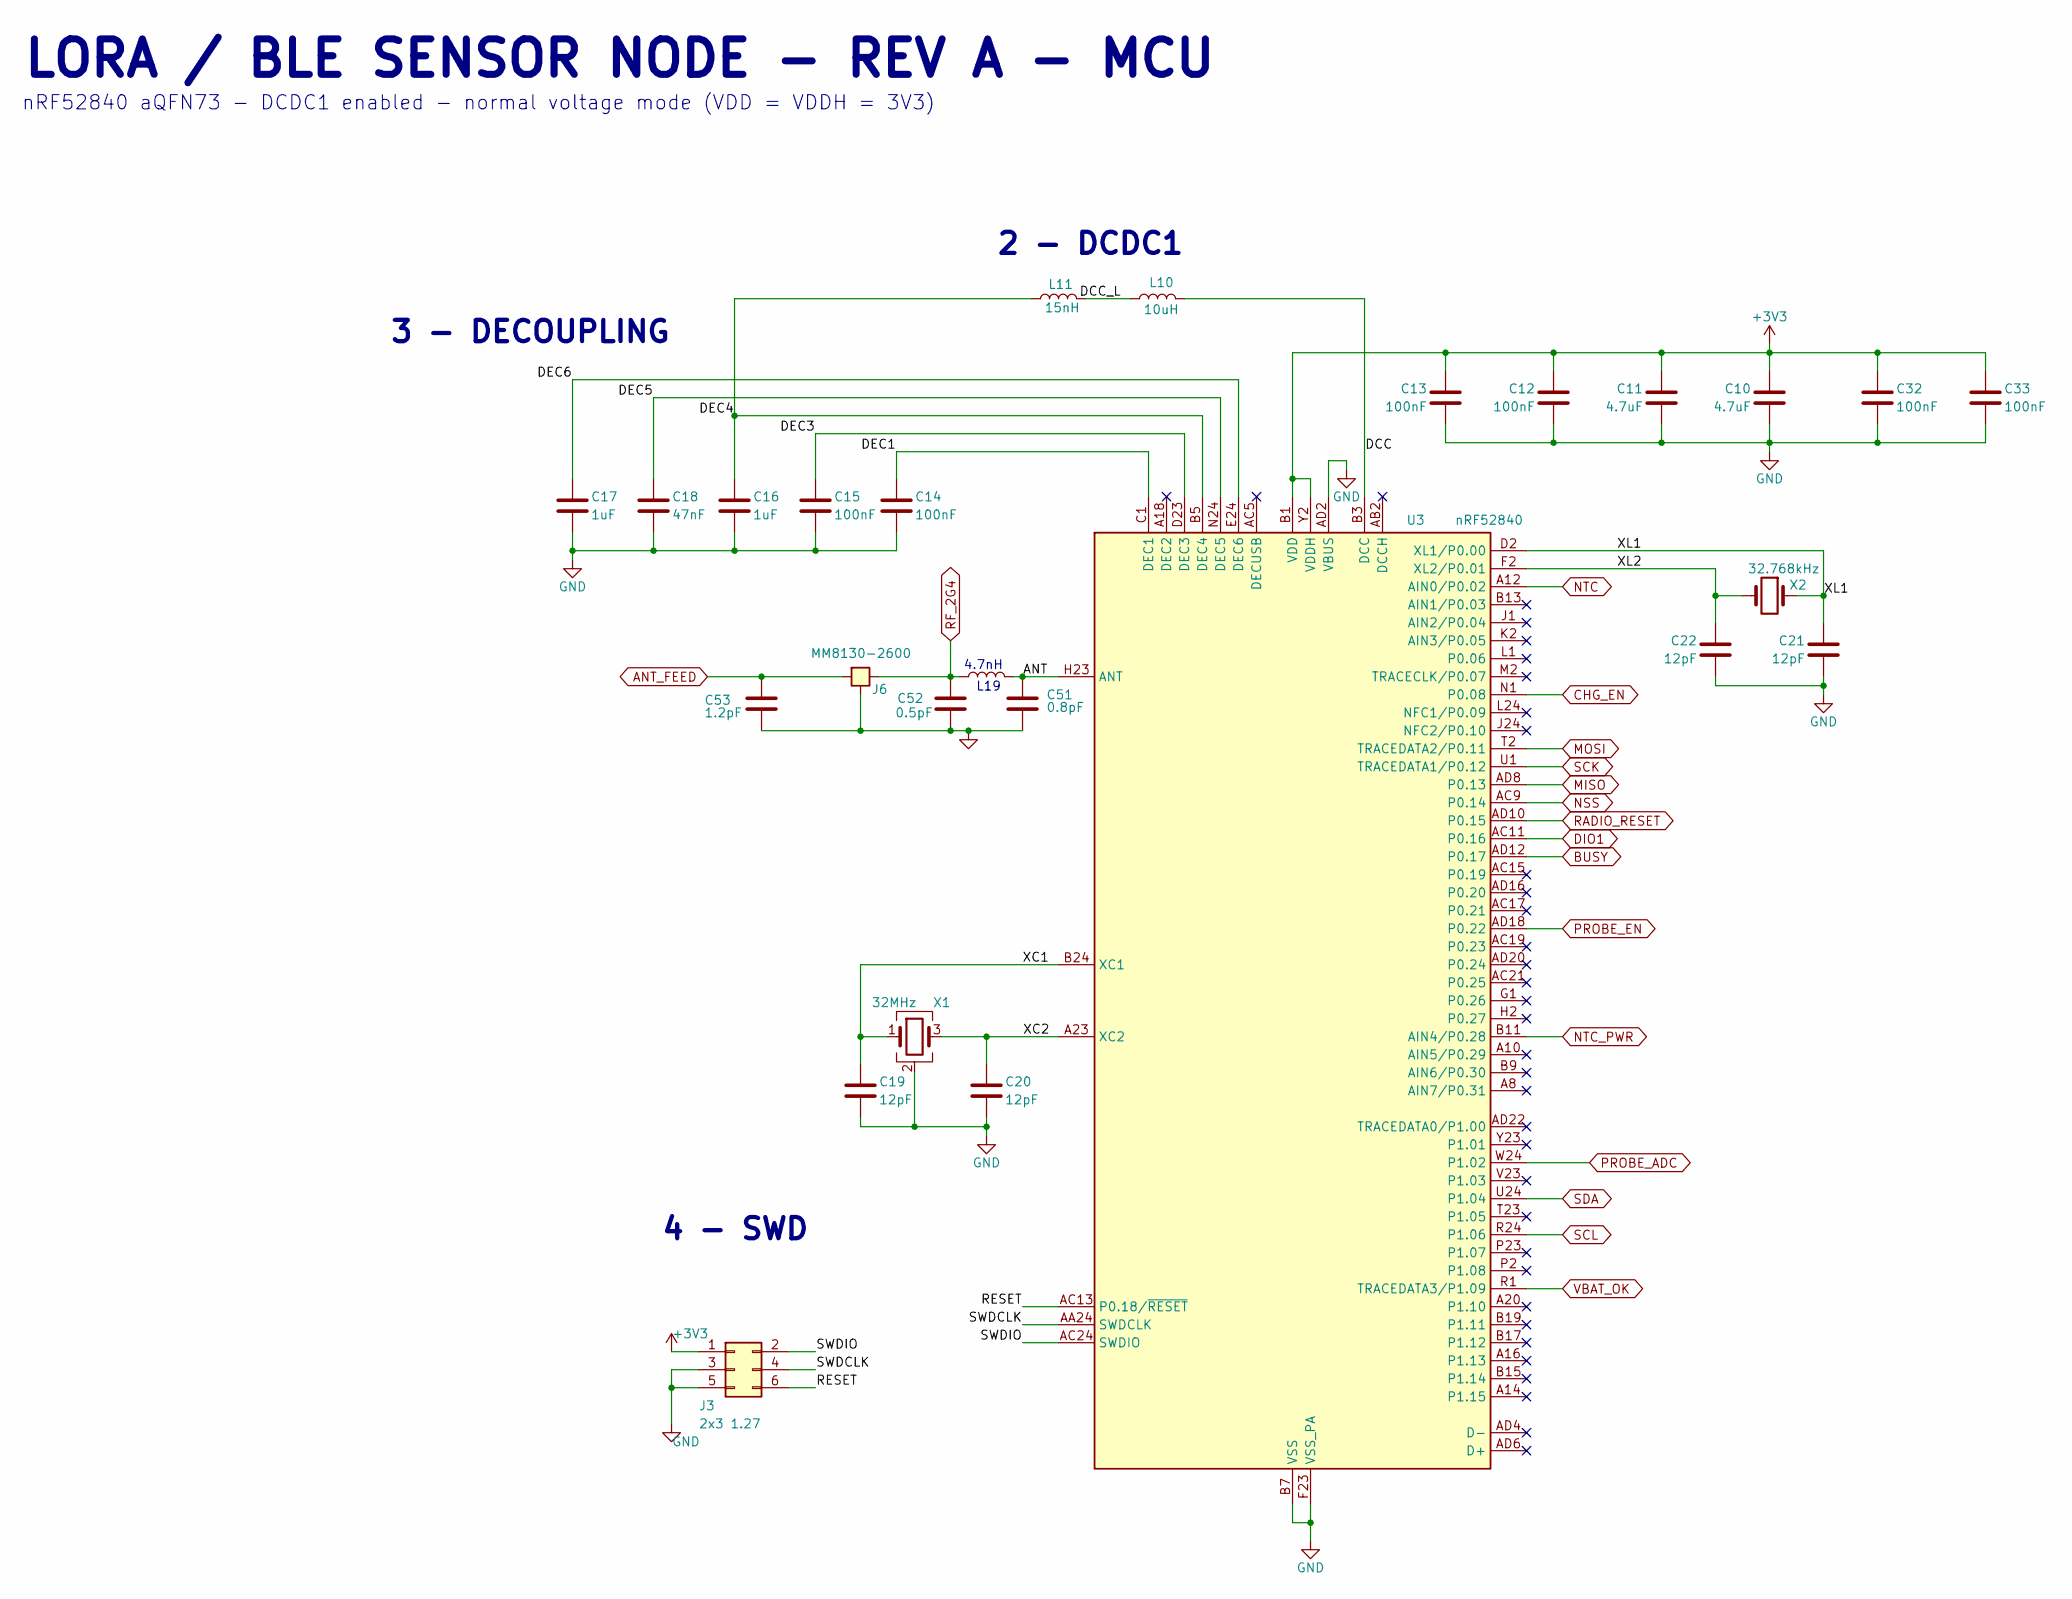
[picture p20: schematic mcu.kicad_sch, LoRa/BLE Sensor Node - MCU]

Parts:
C10, C11: 4.7uF; C_0603_1608Metric; MPN CL10A475KO8NNNC; LCSC C19666
C12, C13, C14, C15, C32, C33: 100nF; C_0402_1005Metric; MPN CL05B104KO5NNNC; LCSC C1525
C16, C17: 1uF; C_0603_1608Metric; MPN CL10B105KA8NNNC; LCSC C29936
C18: 47nF; C_0402_1005Metric; MPN CC0402KRX7R9BB473; LCSC C272875
C19, C20, C21, C22: 12pF; C_0402_1005Metric; MPN CC0402JRNPO9BN120; LCSC C106201
C51: 0.8pF; C_0402_1005Metric; MPN GJM1555C1HR80BB01D; LCSC C76915
C52: 0.5pF; C_0402_1005Metric; MPN GJM1555C1HR50BB01D; LCSC C76911
C53: 1.2pF; C_0402_1005Metric; MPN GJM1555C1H1R2WB01D; LCSC C76899
J3: 2x3 1.27; PinHeader_2x03_P1.27mm_Vertical_SMD; MPN PZ127-2-03-S; LCSC C3975186
J6: MM8130-2600; COAXIAL-SWF; MPN MM8130-2600RB8; LCSC C91633
L10: 10uH; L_0603_1608Metric; MPN MLZ1608N100LT000; LCSC C194437
L11: 15nH; L_0402_1005Metric; MPN LQW15AN15NG00D; LCSC C98055
L19: 4.7nH; L_0402_1005Metric; MPN LQW15AN4N7B00D; LCSC C98064
U3: nRF52840; Nordic_AQFN-73-1EP_7x7mm_P0.5mm; MPN NRF52840-QIAA-R; LCSC C190794
X1: 32MHz; Crystal_SMD_2016-4Pin_2.0x1.6mm; MPN TX201632M4BBCE2T; LCSC C5339095
X2: 32.768kHz; Crystal_SMD_3215-2Pin_3.2x1.5mm; MPN Q13FC13500003; LCSC C99010

Connections:
+3V3: C10.1, C11.1, C12.1, C13.1, C32.1, C33.1, J3.1, U3.A22 (VDD), U3.AD14 (VDD), U3.AD23 (VDD), U3.B1 (VDD), U3.W1 (VDD), U3.Y2 (VDDH); also elsewhere on the board
/MCU/ANT: C51.1, L19.2, U3.H23 (ANT)
/MCU/DCC: L10.1, U3.B3 (DCC)
/MCU/DCC_L: L10.2, L11.1
/MCU/DEC1: C14.1, U3.C1 (DEC1)
/MCU/DEC3: C15.1, U3.D23 (DEC3)
/MCU/DEC4: C16.1, L11.2, U3.B5 (DEC4)
/MCU/DEC5: C18.1, U3.N24 (DEC5)
/MCU/DEC6: C17.1, U3.E24 (DEC6)
/MCU/RESET: J3.6, U3.AC13 (P0.18/~RESET)
/MCU/SWDCLK: J3.4, U3.AA24 (SWDCLK)
/MCU/SWDIO: J3.2, U3.AC24 (SWDIO)
/MCU/XC1: C19.1, U3.B24 (XC1), X1.1
/MCU/XC2: C20.1, U3.A23 (XC2), X1.3
/MCU/XL1: C21.1, U3.D2 (XL1/P0.00), X2.1
/MCU/XL2: C22.1, U3.F2 (XL2/P0.01), X2.2
ANT_FEED: C53.1, J6.3 (ANT)
BUSY: U3.AD12 (P0.17); also elsewhere on the board
CHG_EN: U3.N1 (P0.08); also elsewhere on the board
DIO1: U3.AC11 (P0.16); also elsewhere on the board
GND: C10.2, C11.2, C12.2, C13.2, C14.2, C15.2, C16.2, C17.2, C18.2, C19.2, C20.2, C21.2, C22.2, C32.2, C33.2, C51.2, C52.2, C53.2, J3.3, J3.5, J6.2 (GND), U3.AD2 (VBUS), U3.B7 (VSS), U3.EP (VSS), U3.F23 (VSS_PA), X1.2 (G), X1.4 (G); also elsewhere on the board
MISO: U3.AD8 (P0.13); also elsewhere on the board
MOSI: U3.T2 (TRACEDATA2/P0.11); also elsewhere on the board
NSS: U3.AC9 (P0.14); also elsewhere on the board
NTC: U3.A12 (AIN0/P0.02); also elsewhere on the board
NTC_PWR: U3.B11 (AIN4/P0.28); also elsewhere on the board
PROBE_ADC: U3.W24 (P1.02); also elsewhere on the board
PROBE_EN: U3.AD18 (P0.22); also elsewhere on the board
RADIO_RESET: U3.AD10 (P0.15); also elsewhere on the board
RF_2G4: C52.1, J6.1 (RF), L19.1
SCK: U3.U1 (TRACEDATA1/P0.12); also elsewhere on the board
SCL: U3.R24 (P1.06); also elsewhere on the board
SDA: U3.U24 (P1.04); also elsewhere on the board
VBAT_OK: U3.R1 (TRACEDATA3/P1.09); also elsewhere on the board

Notes on the sheet:
2 - DCDC1
LORA / BLE SENSOR NODE - REV A - MCU
nRF52840 aQFN73 - DCDC1 enabled - normal voltage mode (VDD = VDDH = 3V3)
4 - SWD
L19
3 - DECOUPLING
4.7nH

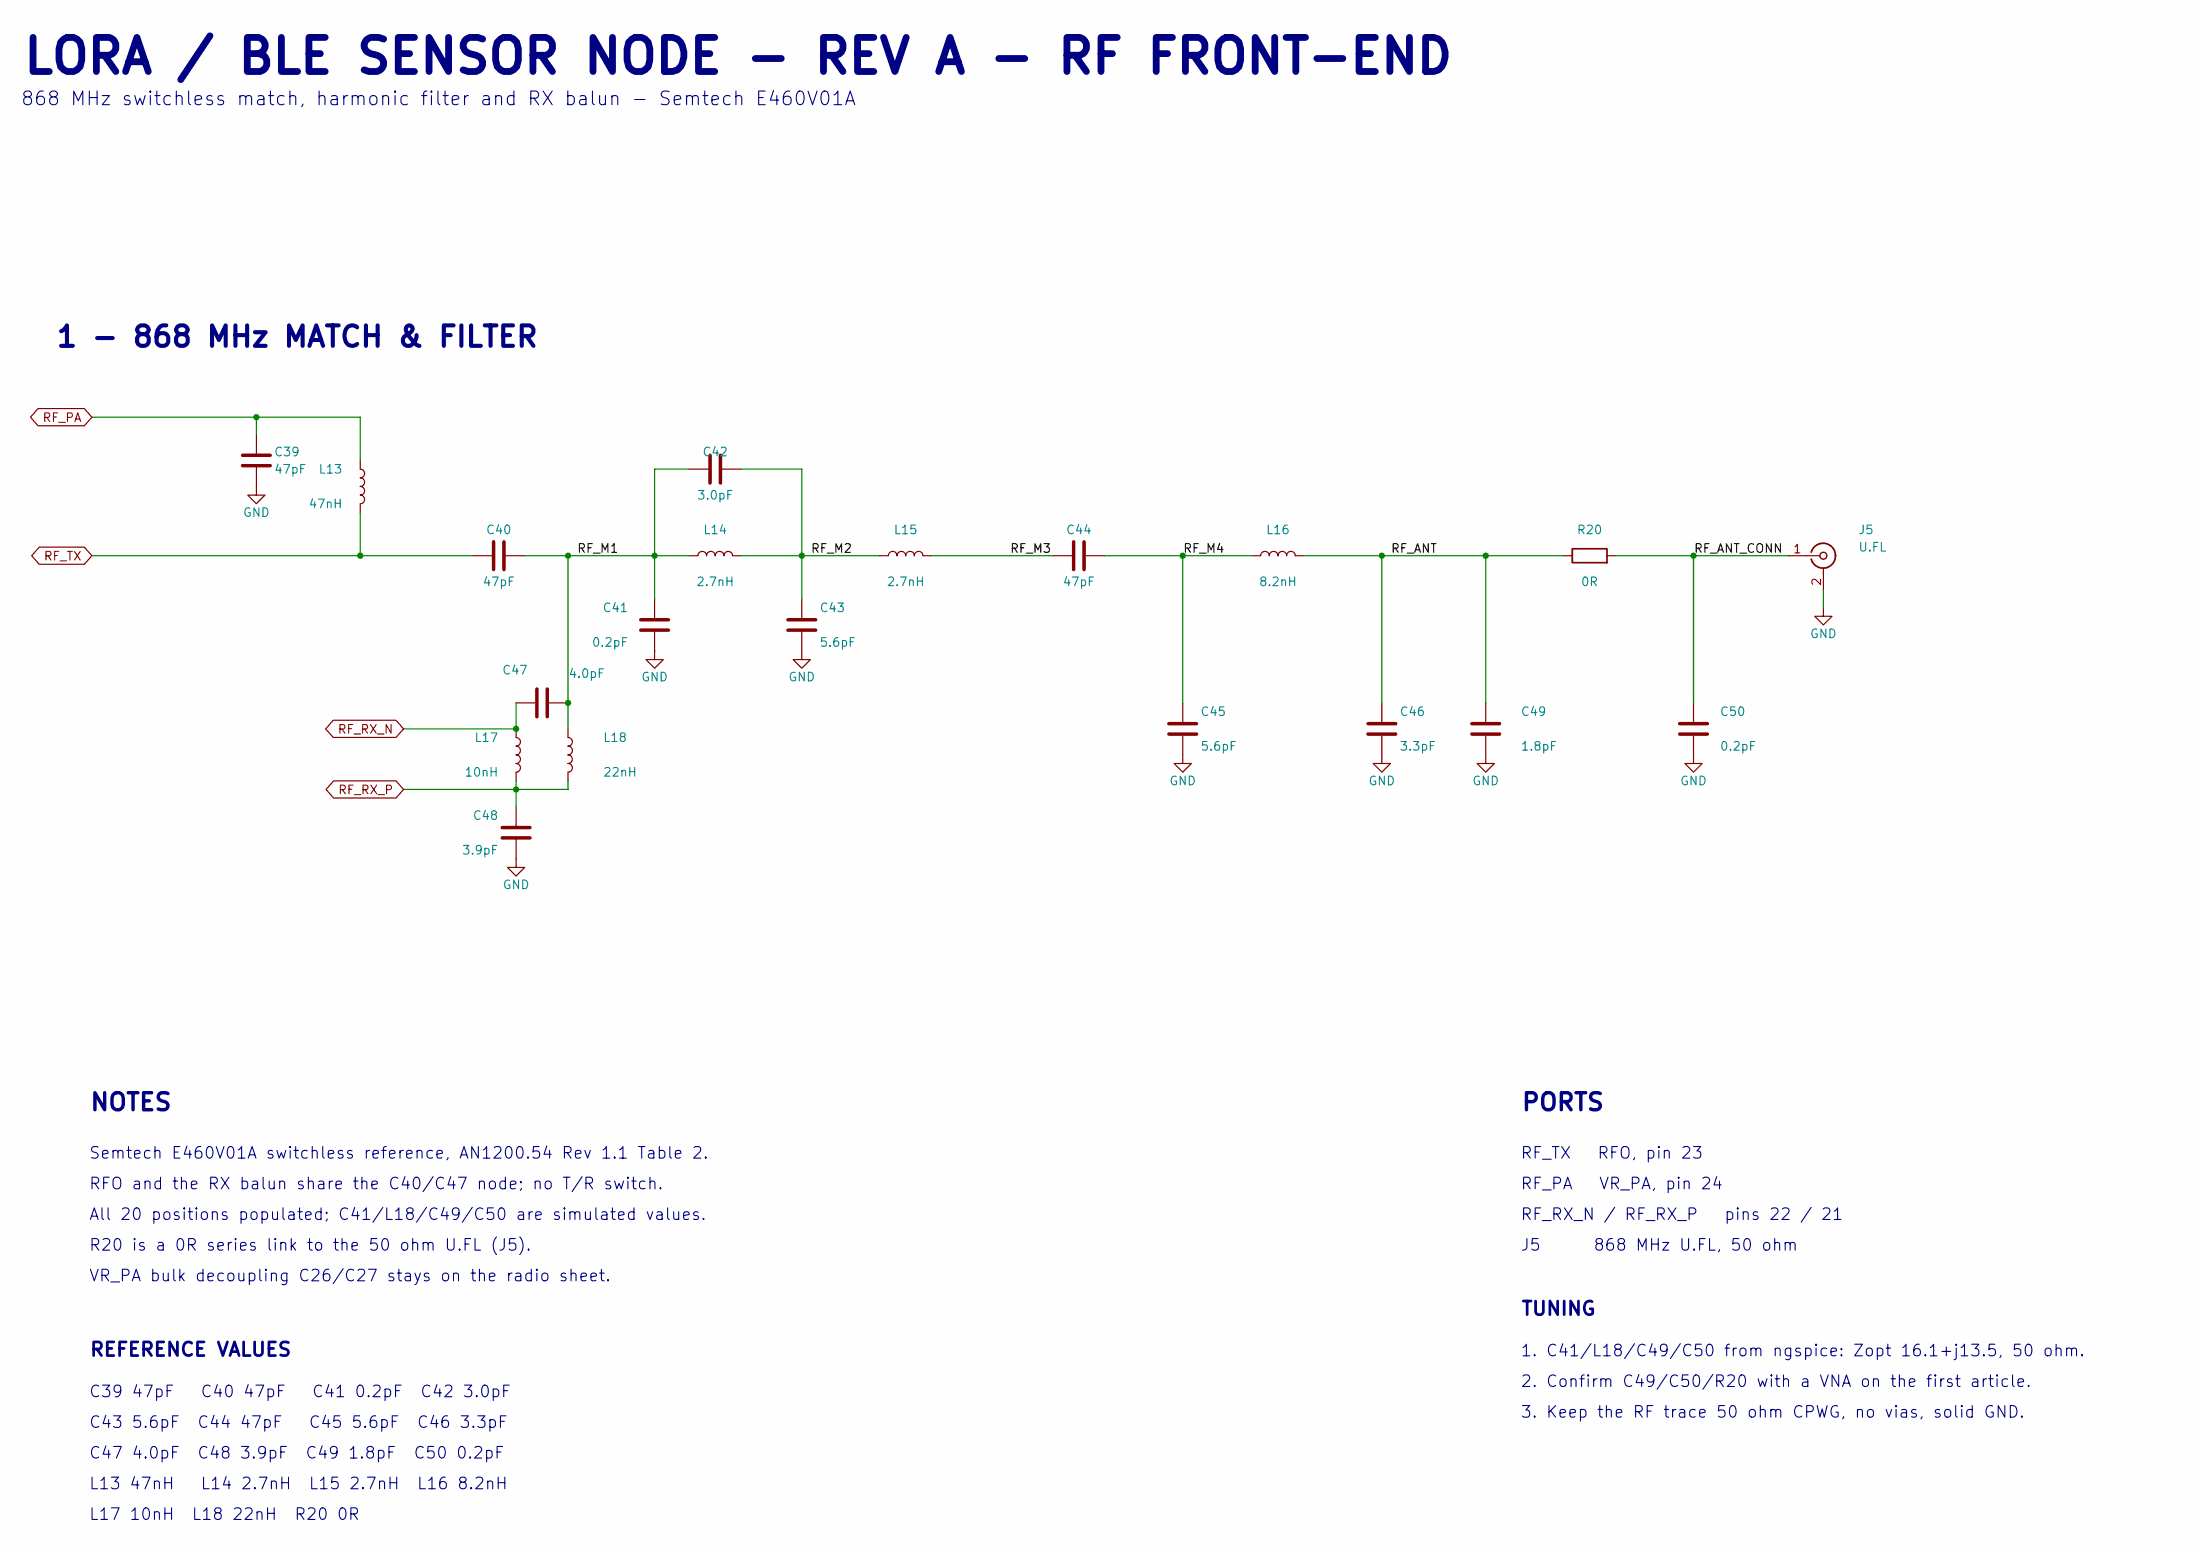
[picture p21: schematic rf.kicad_sch, LoRa/BLE Sensor Node - RF Front-End]

Parts:
C39, C40, C44: 47pF; C_0402_1005Metric; MPN CC0402JRNPO9BN470; LCSC C60137
C41, C50: 0.2pF; C_0402_1005Metric; MPN CQ0402BRNPO9BNR20; LCSC C1855077
C42: 3.0pF; C_0402_1005Metric; MPN CC0402BRNPO9BN3R0; LCSC C327228
C43, C45: 5.6pF; C_0402_1005Metric; MPN CC0402BRNPO9BN5R6; LCSC C505468
C46: 3.3pF; C_0402_1005Metric; MPN CC0402BRNPO9BN3R3; LCSC C327287
C47: 4.0pF; C_0402_1005Metric; MPN CC0402BRNPO9BN4R0; LCSC C541337
C48: 3.9pF; C_0402_1005Metric; MPN CC0402BRNPO9BN3R9; LCSC C505474
C49: 1.8pF; C_0402_1005Metric; MPN CC0402BRNPO9BN1R8; LCSC C327209
J5: U.FL; U.FL_Hirose_U.FL-R-SMT-1_Vertical; MPN U.FL-R-SMT-1(80); LCSC C88374
L13: 47nH; L_0402_1005Metric; MPN LQW15AN47NG00D; LCSC C22334
L14, L15: 2.7nH; L_0402_1005Metric; MPN LQW15AN2N7C00D; LCSC C98058
L16: 8.2nH; L_0402_1005Metric; MPN LQW15AN8N2G00D; LCSC C84404
L17: 10nH; L_0402_1005Metric; MPN LQW15AN10NG00D; LCSC C90642
L18: 22nH; L_0402_1005Metric; MPN LQW15AN22NG00D; LCSC C86129
R20: 0R; R_0402_1005Metric; MPN 0402WGF0000TCE; LCSC C17168

Connections:
/RF/RF_ANT: C46.1, C49.1, L16.2, R20.1
/RF/RF_ANT_CONN: C50.1, J5.1 (In), R20.2
/RF/RF_M1: C40.2, C41.1, C42.1, C47.1, L14.1, L18.1
/RF/RF_M2: C42.2, C43.1, L14.2, L15.1
/RF/RF_M3: C44.1, L15.2
/RF/RF_M4: C44.2, C45.1, L16.1
GND: C39.2, C41.2, C43.2, C45.2, C46.2, C48.2, C49.2, C50.2, J5.2 (Ext); also elsewhere on the board
RF_PA: C39.1, L13.1; also elsewhere on the board
RF_RX_N: C47.2, L17.1; also elsewhere on the board
RF_RX_P: C48.1, L17.2, L18.2; also elsewhere on the board
RF_TX: C40.1, L13.2; also elsewhere on the board

Notes on the sheet:
REFERENCE VALUES
RF_PA VR_PA, pin 24
J5 868 MHz U.FL, 50 ohm
1. C41/L18/C49/C50 from ngspice: Zopt 16.1+j13.5, 50 ohm.
RFO and the RX balun share the C40/C47 node; no T/R switch.
2. Confirm C49/C50/R20 with a VNA on the first article.
PORTS
TUNING
LORA / BLE SENSOR NODE - REV A - RF FRONT-END
L17 10nH L18 22nH R20 0R
All 20 positions populated; C41/L18/C49/C50 are simulated values.
RF_RX_N / RF_RX_P pins 22 / 21
C39 47pF C40 47pF C41 0.2pF C42 3.0pF
868 MHz switchless match, harmonic filter and RX balun - Semtech E460V01A
R20 is a 0R series link to the 50 ohm U.FL (J5).
3. Keep the RF trace 50 ohm CPWG, no vias, solid GND.
RF_TX RFO, pin 23
1 - 868 MHz MATCH & FILTER
C43 5.6pF C44 47pF C45 5.6pF C46 3.3pF
L13 47nH L14 2.7nH L15 2.7nH L16 8.2nH
VR_PA bulk decoupling C26/C27 stays on the radio sheet.
Semtech E460V01A switchless reference, AN1200.54 Rev 1.1 Table 2.
NOTES
C47 4.0pF C48 3.9pF C49 1.8pF C50 0.2pF
