Mehdi-Ldj/lora-ble-sensor-node/hardware/rev-a/lora-node.kicad_pcb

## KiCad design hardware/rev-a/lora-node.kicad_pcb (continued)

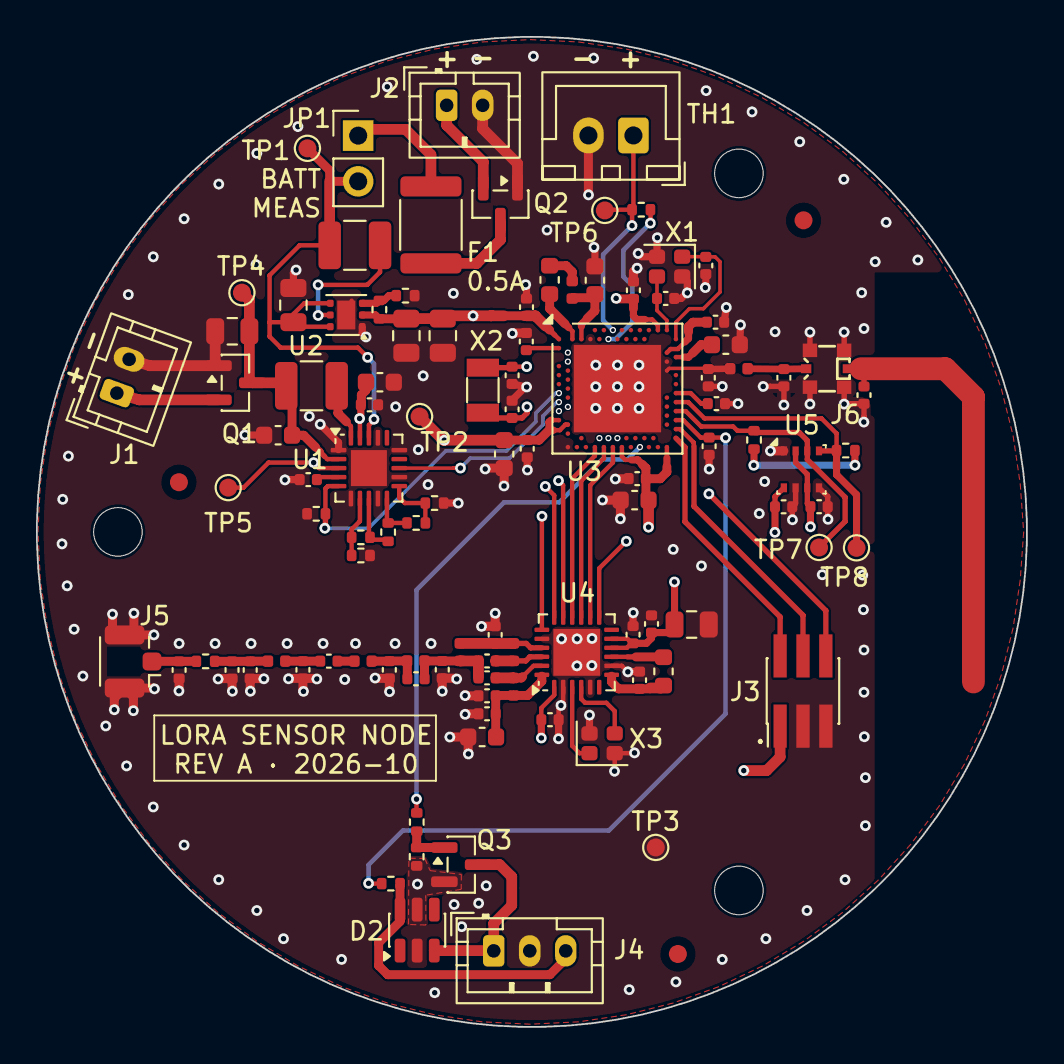
[picture p22: board lora-node.kicad_pcb from above]

Board: 4 copper layers, 55.0 x 55.0 mm, 110 parts (0 on the bottom side), 66 nets.

Other parts of the board:
FID1, FID2, FID3: Fiducial; Fiducial_1mm_Mask2mm
H1, H2, H3: M2.5; MountingHole_2.7mm_M2.5_DIN965
