Mehdi-Ldj/lora-ble-sensor-node/(commit log)

2026-10-28 Rev A: hardware, simulation results and build notes
    [MM8130-2600.step, SMD1812P050TF-30.step, lora-node.kicad_pcb, lora-node.kicad_sch, mcu.kicad_sch, power.kicad_sch, radio.kicad_sch, rf.kicad_sch]
2026-10-28 README: the schematic is a PDF; KiCanvas carries the board
2026-10-28 Schematic: cosmetic pass over the sheet artwork
    [lora-node.kicad_sch, mcu.kicad_sch, power.kicad_sch, radio.kicad_sch, rf.kicad_sch, sensors.kicad_sch]
